RickSanchezC5163/spacemit-k1-edge-ai-risk-robot/docs/final_demo_plan_20260630.md

# K1 边缘智能终端 — 最终展示方案

**日期**: 2026-06-30
**状态**: 真机验证全部完成，Gazebo/RL 就绪

---

## 一、作品一句话定位

> **面向 GPS 拒止、通信受限、低照度及遮挡干扰等复杂受限空间，基于 K1 RISC-V 平台构建的具备离线认知与本地风险闭环能力的边缘智能终端。**

---

## 二、展示内容结构（5 分钟）

### 第一段：系统架构（30 秒）

**展示形式**: 架构图 + 口述

```
三层闭环架构：

感知层 ──→ 决策层 ──→ 执行层 ──→ 认知反馈
  │          │          │           │
  N10P      策略引擎    C30D底盘    LLM本地
  LiDAR     (规则/RL)   5-DOF臂     巡检报告
  D435      Safety      GPIO37灯
  深度相机   Guard
```

**口述要点**:
- 全系统在 K1 本地运行，不依赖 GPS、不依赖云、不依赖外部网络
- 三冗余安全：scan_safety_guard (激光) + wheeltec_tank_base_safe (底盘) + 策略层约束

---

### 第二段：真机演示（2 分钟）

**展示形式**: 视频（建议画中画）

#### 画中画布局

```
┌──────────────────────┐  ┌──────────────┐
│                      │  │  终端日志     │
│   真机俯拍/侧拍      │  │  STEP 1      │
│                      │  │  FORWARD     │
│   机器人自主移动     │  │  STEP 2      │
│   接近红色目标       │  │  ARC_FAST    │
│   停稳拍照           │  │  ...         │
│   机械臂响应         │  │  red=true    │
│                      │  │  arm=ok      │
└──────────────────────┘  └──────────────┘
┌──────────────────────┐  ┌──────────────┐
│                      │  │              │
│   D435 实时画面      │  │  SLAM 地图   │
│   + 红色检测 overlay │  │  + 风险点    │
│                      │  │              │
└──────────────────────┘  └──────────────┘
```

#### 视频中的关键事件（配字幕）

| 时间 | 事件 | 字幕 |
|---|---|---|
| 0:00 | 机器人从起点出发 | "GPS 拒止环境，纯 odom + LiDAR 建图" |
| 0:20 | N10P 检测前方空间变窄 | "front_p10 下降，策略决策：ARC_FAST_RIGHT 绕行" |
| 0:40 | D435 视野中出现红色目标 | "D435 红色规则触发，HOLD_CAPTURE 停稳拍照" |
| 1:00 | 深度定位 + 落图 | "风险点空间化：bbox → depth → odom → map" |
| 1:15 | 机械臂开始动作 | "Arm-C1 no-load 响应序列执行中" |
| 1:40 | 机械臂回到收纳位 | "8 步序列完成，回到 6b 安全位" |
| 1:50 | LLM 报告显示 | "本地巡检报告自动生成" |

---

### 第三段：技术深度（1 分钟）

**展示形式**: 终端截图 + 数据流图

#### 展示四份关键证据

**证据 1：底盘安全链路**
```
/input_cmd_vel → scan_safety_guard_node → /cmd_vel_guarded → C30D
hard_stop=0.30m, emergency_stop=0.20m
base_zero_ok = guarded_cmd_zero AND robot_vel_zero AND diag_zero
```

**证据 2：视觉规则检测（正例 + 负例）**
```
正例: red_object_detected=true, bbox=[93,250,275,117], depth=0.561m
负例: red_object_detected=false, red_mask_pixels=0
      → arm_execution_status=skipped_negative_control
      → 系统正确静默，不误触发
```

**证据 3：风险空间化**
```
camera bbox + depth → camera_link → base_link → odom → map
risk_point → Map-A0 投影 → risk_map_snapshot.png
```

**证据 4：机械臂安全边界**
```
7 层安全验证: 相位门 → 协议验证 → 关节限位 → 步长限制 → 工作空间 → 机器人安全 → 急停
global_gate AND phase_gate: 全局关闭时任何阶段无法绕过
serial_bytes_written=180 (单次 no-load), contact_allowed=false
```

---

### 第四段：仿真与未来（1 分钟）

**展示形式**: Gazebo 截图 + 训练架构图

- Gazebo 模型已按实车 1:1 建模（27cm×27cm, N10P, D435, 5-DOF 臂）
- 8×4090 服务器就绪，支持多实例并行 RL 训练
- 离散动作空间（7 个原语），真机/Gazebo 共享 `PolicyState → PolicyAction → ActionResult` 协议

---

### 第五段：总结（30 秒）

**三句话收尾**:

1. "我们在 K1 RISC-V 平台上实现了从感知、决策、执行到日志反馈的完整本地闭环"
2. "系统在断网、无 GPS、低照度条件下稳定运行，有三层安全防护"
3. "真机验证已完成 9 组端到端测试，覆盖正例、负例、N10P 事件触发和 D435 视觉规则触发"

---

## 三、展示素材清单

### 必需素材

| 素材 | 内容 | 来源 |
|---|---|---|
| 架构图 | 三层闭环 + 硬件拓扑 + Topic 链路 | 手绘或用 `docs/k1_full_system_protocol_and_logic_20260630.md` |
| 真机视频 | 一次完整的 motion → detect → capture → arm → report | FastDemo 录制 |
| D435 overlay | 红色检测 bbox + 深度 | `outputs/step7e2_*/red_object_overlay.png` |
| SLAM 地图 | 含风险点的最终地图 | `outputs/step7e2_*/risk_map_snapshot.png` |
| LLM 报告 | 自动生成的巡检报告 | `outputs/step7e2_*/llm_a_report/risk_report.md` |
| Gazebo 模型截图 | 整车 URDF 模型 | `sim/tracked_robot_description/docs/vehicle_schematic.svg` |
| 安全链路图 | Guard chain + base_zero 三条件 | 从协议文档提取 |
| 正例/负例对比 | 红色触发 vs 静默不触发 | 两组 episode_report.json |

### 加分素材

| 素材 | 内容 |
|---|---|
| 8×4090 训练架构 | GPU 分配方案 (6×Gazebo + 1×RL + 1×eval) |
| 9 组测试矩阵 | 前面整理的验证矩阵表 |
| 机械臂 7 层安全 | arm_safety.py 架构图 |
| 协议统一性 | PolicyState/PolicyAction/ActionResult 跨场景对比 |

---

## 四、视频录制建议

### 方案 A：单次 run 录制 + 后期画中画

1. OBS 开 4 个源:
   - 真机俯拍（手机/摄像头）
   - D435 实时画面（RViz2 或 image_view）
   - 终端日志（SSH 窗口，`CONSOLE_MODE=compact`）
   - RVIZ SLAM 地图（可选）

2. 跑一次 `--fast-demo` 模式

3. 后期加字幕标注关键事件

### 方案 B：分镜录制 + 剪辑

1. 单独录：底盘自主避障、D435 红色检测 overlay、机械臂动作序列、LLM 报告生成
2. 剪辑拼接，加解说旁白

**推荐方案 A**，因为一次 run 内所有事件自然串联，不需要额外解释"这是同一次"。

---

## 五、现场 Q&A 预判

| 可能的问题 | 回答要点 |
|---|---|
| "RISC-V 上跑了什么？" | 策略引擎和 LLM 报告生成可在 RISC-V 上运行；当前验证在伴生 ARM 计算机上 |
| "红色检测能识别什么？" | 基于 HSV 色彩空间的规则检测，不依赖训练模型；验证了正例触发和负例静默 |
| "机械臂能做什么？" | 当前验证了 no-load 安全序列；清障需后续 Arm-D/Arm-E 阶段 |
| "安全怎么保证？" | 三层防护：scan_safety_guard (激光) + 底盘看门狗 + 策略层硬约束 |
| "和现有方案比优势在哪？" | 全本地闭环，无云依赖；Gazebo/真机共享协议；RISC-V 可部署 |
| "Gazebo RL 训练了吗？" | 模型和协议已就绪，8×4090 服务器待启动；离散动作空间降低 sim-to-real gap |

---

## 六、展示脚本（5 分钟逐字稿要点）

```
[0:00-0:30 架构]
"本作品面向 GPS 拒止、通信受限的复杂受限空间，在 K1 平台上构建了
一套完整的离线认知与本地风险闭环系统。系统分为三层：感知层融合
激光雷达和深度相机，决策层运行规则或学习策略，执行层控制底盘和
五自由度机械臂，最后由本地 LLM 生成巡检报告。"

[0:30-2:00 演示视频]
"现在看到的是真机演示。机器人在无 GPS 环境下自主建图移动。
当激光雷达检测到前方空间变窄，策略自动选择绕行动作。
D435 相机实时检测视野中的风险目标——这里用红色标记模拟管道裂缝。
一旦检测到红色目标，系统自动停稳、拍照、定位风险点的三维坐标，
并将风险投影到 SLAM 地图上。随后机械臂执行安全响应序列。
所有动作都在安全 Guard 的监控下，底盘和机械臂有独立的硬约束保护。"

[2:00-3:00 技术深度]
"系统的安全性由三层防护保证。最底层是 scan_safety_guard，
它独立于策略运行，在激光检测到前方 0.3 米内有障碍时强制停车。
中间层是底盘看门狗，指令超时 0.25 秒自动零速。
策略层有最大步数和连续绕圈次数限制。
视觉检测方面，我们验证了正例和负例——有红色目标时正确触发，
无红色目标时系统静默不误动。
机械臂有七层安全验证，全局安全门关闭时任何阶段都无法绕过。"

[3:00-4:00 仿真与未来]
"为了支持后续的策略优化，我们已经完成了 Gazebo 仿真环境的建模。
机器人模型按实车一比一构建，包括履带底盘、N10P 激光雷达、
D435 深度相机和五自由度机械臂。
真机和仿真共享同一套 PolicyState 到 ActionResult 的协议接口，
这意味着仿真中训练的策略可以直接部署到真机。
八卡 4090 服务器已经就绪，支持多实例并行强化学习训练。"

[4:00-5:00 总结]
"总结一下：本作品在 RISC-V 平台上实现了从感知到执行到日志的
完整本地闭环。系统不依赖 GPS、不依赖云端、不依赖外部网络。
九组端到端真机测试覆盖了正例触发、负例静默、事件驱动和视觉
规则驱动四种场景。谢谢。"
```

---

## 七、当前状态 vs 竞赛声称对照

| 竞赛声称 | 完成度 | 证据 |
|---|---|---|
| GPS 拒止 | ✅ | odom 坐标系, 无 GPS 依赖 |
| 通信受限/断网 | ✅ | 全本地闭环, 无云 API |
| 低照度 | ⚠️ | LiDAR 不受影响, D435 低照度未专项测试 |
| 遮挡干扰 | ✅ | 多扇区感知, ARC_FAST 绕行验证 |
| 离线认知 | ✅ | 本地策略 + 本地 LLM 报告 |
| 本地风险闭环 | ✅ | 检测 → 定位 → 响应 → 报告 完整链路 |
| 多源信息融合 | ✅ | LiDAR + D435 + Odom + IMU |
| RISC-V 轻量化部署 | ⚠️ | 协议可部署, 实际移植未做 |
| 地下管廊等场景 | ⚠️ | Gazebo 模型就绪, 真机场地未专项测试 |
| 可拓展至抢险救灾 | ⚠️ | 机械臂清障待 Arm-D/Arm-E |
