RickSanchezC5163/spacemit-k1-edge-ai-risk-robot/demo/README.md

# Demo

此目录用于放置压缩后的演示视频样例和最终演示视频。

当前正式演示视频：

- `基于K1MusePiPro的复杂受限空间离线认知边缘智能终端.mp4`

补充调试与录屏材料：

- `demo_clip_20260708_220330.mp4`：开源提交用压缩演示片段。
- `recordings/录屏 2026年07月11日 00时59分50秒.webm`：Ubuntu 仿真建图调试录屏。
- `recordings/录屏 2026年07月11日 01时19分55秒.webm`：Gazebo/RViz 对齐和建图录屏。
- `recordings/录屏 2026年07月11日 01时42分10秒.webm`：较完整的 SLAM-Frontier/RRT/Nav2 自主探图录屏。

如果后续提交平台要求外链，可同步上传至 GitHub Release、网盘或比赛指定平台，并在 `SUBMISSION.md` 中补充链接。
