RickSanchezC5163/spacemit-k1-edge-ai-risk-robot/docs/汇报.md

# 组会汇报稿

这段时间我主要完成了小车从硬件驱动到边缘 AI 演示链路的基础打通，现在项目已经从“单个模块调通”推进到“整车稳定运行和演示链路打磨”阶段，准备在接下来几天补齐资料，上交素材。

作品主要是基于N10P雷达、D435深度相机的对于外部环境的感知,通过N10P雷达进行稳定的二维建图,结合YOLO模型识别地图上的风险点,并结合深度相机的雷达数据,准确地标定出地图上某个位置存在的风险。同时如果有堵塞的识别,最后通过机械臂进行排障的一个对于受限环境内的整个风险的排查系统。
整车的自主操作实现基于gazebo仿真和ROS2 Humble的Nav2导航栈,通过RRT算法进行自主建图和路径规划,结合雷达和深度相机的感知数据,实现对于受限环境内的自主探索和风险排查。

其中，雷达30Hz，车底盘20Hz，D435 30Hz。YoloV8n 10Hz，Qwen-0.5b模型每秒20 tokens。
YoloV8n Qwen-0.5b模型都是本地部署的，完全不依赖云端推理。基于官方提供的Ep核加速，相比于全cpu有明显的性能提升。

结合题目要求,需要本地部署大模型,此处考虑到了对于风险识别的汇总应用。大模型主要是通过对于本地资料,比如说图片、文字,我们的风险汇报的汇总,结合具体的地图环境，最后呈现给用户一个稳定的受限区域内地图样貌，地图上的各个风险判定,以及我们车自主完成的一些风险排查动作的汇报。

### 现在进度： 
1. yolov8n的本地部署
2. RRT的自主建图
3. 机械臂的排障动作
4. 低照度补光灯的控制
5. 本地大模型的部署和运行都已经完成

### 现在尚待补充的内容主要是：
1. 进一步提高整车长时间运行稳定性
2. 整理演示视频、运行日志和关键指标数据
3. 完善 PPT 里的技术路线和评奖材料
4. 后续准备补充RRT辅助RL训练的自主探索和排障动作,实现对于风险事件的解释和处置建议生成

## 1. 底层硬件联调

目前 K1 Muse Pi Pro 已经重新刷入 Bianbu LXQT v2.3.3 比赛固件，并完成了 ROS2 Humble 环境适配。

底盘使用 C30D Tank 固件，N10P 雷达、D435 深度相机、PWM 补光灯、总线舵机和本地 LLM 服务都已经完成基础接入测试。

其中底盘一开始存在停车拖尾和 odom 严重不准的问题。后面通过修改 STM32 固件里的编码器参数，把 Tank 车型从错误的 500 线光电编码器参数改成 GMR 编码器参数，odom 和实际运动的一致性明显改善。

## 2. 安全底盘和建图链路

目前已经跑通：

```text
N10P /scan
+ C30D /odom
+ odom -> base_footprint TF
+ slam_toolbox /map
```

同时加了一层安全控制，不让 Nav2 或手动速度直接裸连底盘。

当前结构是：

```text
/input_cmd_vel 或 Nav2 /cmd_vel_raw
-> scan_safety_guard_node
-> /cmd_vel_guarded
-> Python Tank base
-> C30D
```

这样可以做低速人工建图、小目标 Nav2 测试，并且前方有障碍时可以触发安全停车。

目前还没有宣称完整自动探索，只是完成了“人工/受控低速建图 + 安全停车”的 MVP。

## 3. 视觉和风险闭环

### 3.1 硬件和模型部署

- D435 相机：完成 RGB 和深度采集测试
- YOLO 风险检测模型：已部署本地推理

### 3.2 完整处理链路

```text
D435 图像
  ↓
YOLO 本地推理
  ↓
风险事件生成
  ↓
event_logger 记录
  ↓
地图上生成风险点
  ↓
输出报告和可视化结果
```

### 3.3 核心价值

端侧视觉识别，不依赖云端推理，充分体现 RISC-V 端侧 AI 能力。

## 4. 本地 LLM 和认知层

现在本地 LLM 已经部署完成，后续重点不是再证明“能不能跑”，而是稳定运行和接入完整任务链路。

LLM 主要负责：

```text
风险事件解释
处置建议生成
任务过程摘要
演示问答和报告生成
```

这样系统可以形成：

```text
传感器感知
-> 本地模型识别
-> 风险分级
-> 本地 LLM 解释和总结
-> 执行反馈
```

这部分是项目里“RISC-V 端侧 AI”的重要体现。

## 5. 低照度补光闭环

目前已经完成 PWM 灯控测试，可以通过软件控制补光灯亮灭和亮度调节。

现在也做了自适应补光逻辑：

```text
D435 检测低照度
-> 系统自动调整补光亮度
-> 再次观察画面亮度是否恢复
-> 记录风险事件和处理结果
```

这个可以作为一个比较清晰的比赛演示场景：

```text
低光环境下，机器人自动补光并重新评估风险。
```

## 6. 机械臂和排障接口

总线舵机已经完成串口控制测试，多个舵机编号和基础动作都已经验证。

目前机械臂部分还没有做真实负载排障，当前定位是“人工确认后的空载固定动作响应”，避免现阶段误动作损坏结构。

## 7. 当前完整演示链路

目前项目已经形成了一条比较完整的初赛演示链：

```text
低速建图
-> 发现低照度或障碍风险
-> D435/YOLO 本地识别
-> 风险分级和日志记录
-> 自动补光或停车
-> 本地 LLM 输出风险解释和处置建议
-> 地图/报告中输出风险点
-> 人工确认后机械臂执行固定响应动作
```

## 8. 下一步计划

接下来我准备优先做三件事：

1. 继续提高整车长时间运行稳定性。
2. 整理演示视频、运行日志和关键指标数据。
3. 完善 PPT 里的技术路线和评奖材料。

整体重点会放在：

```text
RISC-V 端侧 AI
多源感知
本地 LLM 认知解释
安全运动闭环
离线运行能力
```
