RickSanchezC5163/spacemit-k1-edge-ai-risk-robot/evidence/p4_guarded_auto_mapping_20260629/maps/spatial_s_p4r_20260629_001054_01_forward_0p15_marked_zoom.png

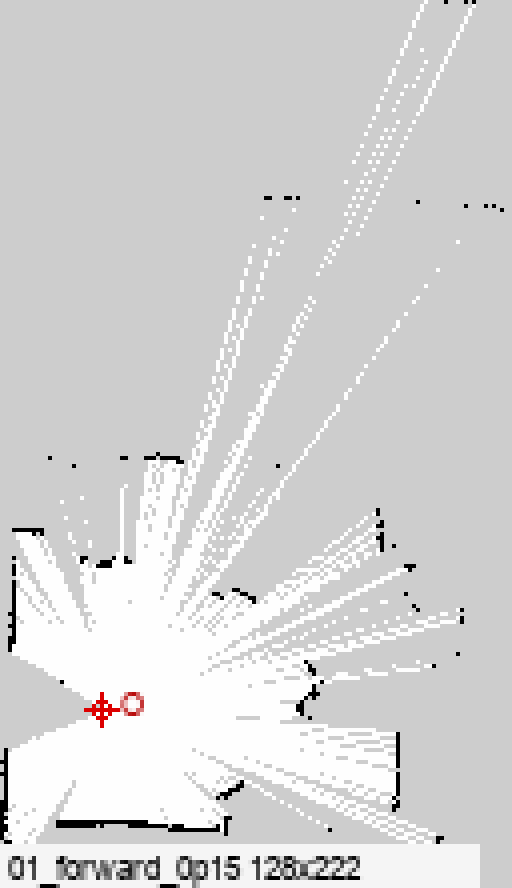
evidence/p4_guarded_auto_mapping_20260629/maps/spatial_s_p4r_20260629_001054_01_forward_0p15_marked_zoom.png
