RickSanchezC5163/spacemit-k1-edge-ai-risk-robot/maps/prelim_remote_mapping/map_20260703_095806_preview.png

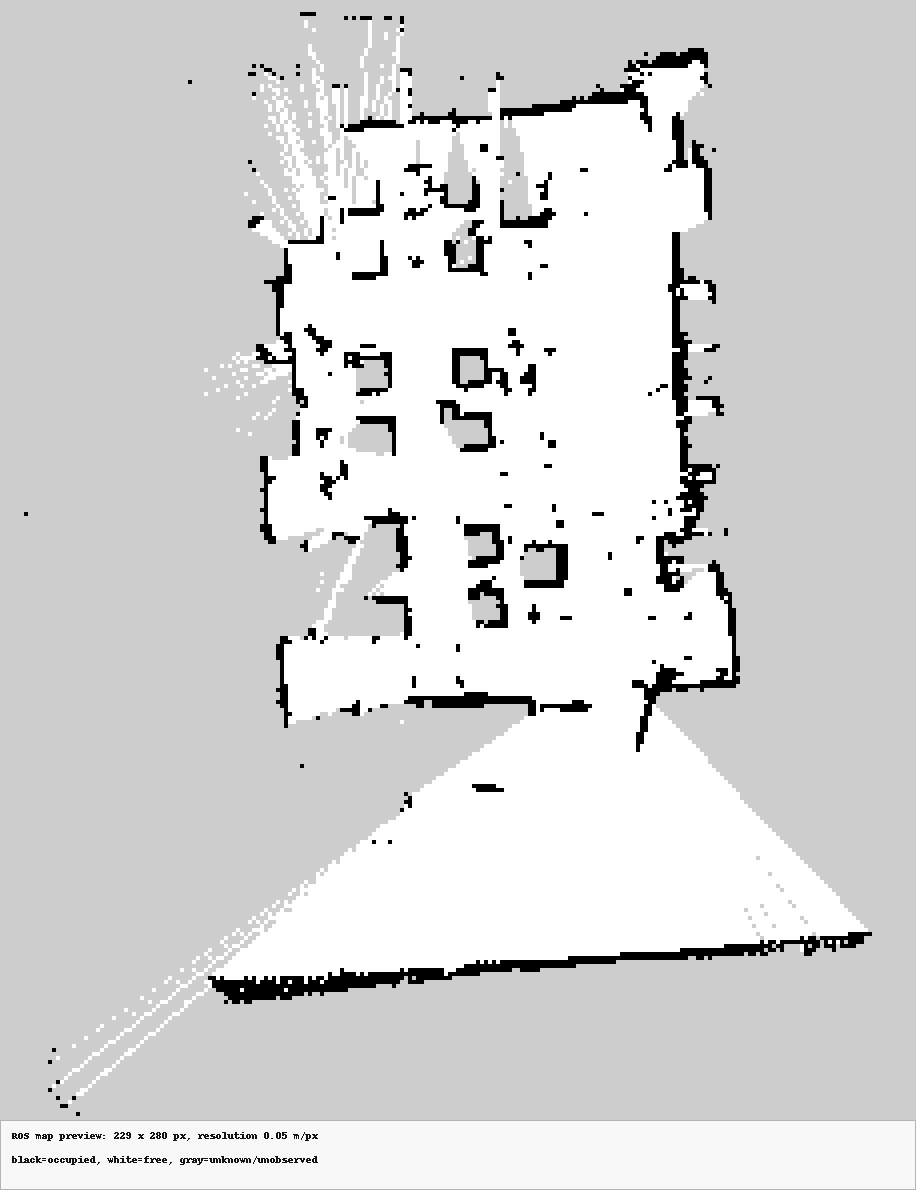
maps/prelim_remote_mapping/map_20260703_095806_preview.png
