RickSanchezC5163/spacemit-k1-edge-ai-risk-robot/maps/prelim_remote_mapping/map_only_20260706_191353_preview.png

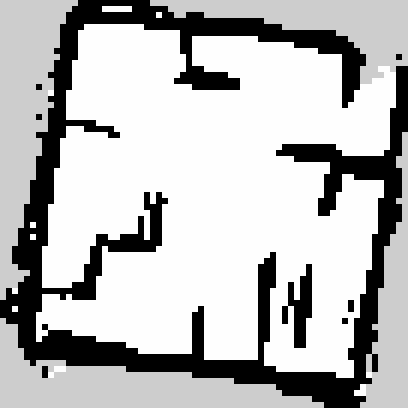
maps/prelim_remote_mapping/map_only_20260706_191353_preview.png
