RickSanchezC5163/spacemit-k1-edge-ai-risk-robot/maps/prelim_remote_mapping/map_rerun_20260706_192358_preview.png

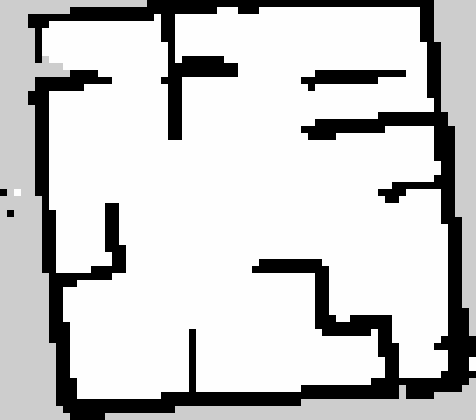
maps/prelim_remote_mapping/map_rerun_20260706_192358_preview.png
