RickSanchezC5163/spacemit-k1-edge-ai-risk-robot/maps_preview/current_map_preview_20260627.png

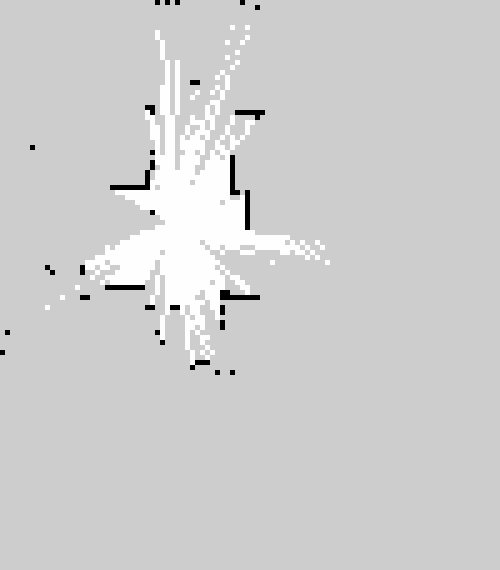
maps_preview/current_map_preview_20260627.png
