RickSanchezC5163/spacemit-k1-edge-ai-risk-robot/maps_preview/mapping_fixed_odom_20260628_085623.png

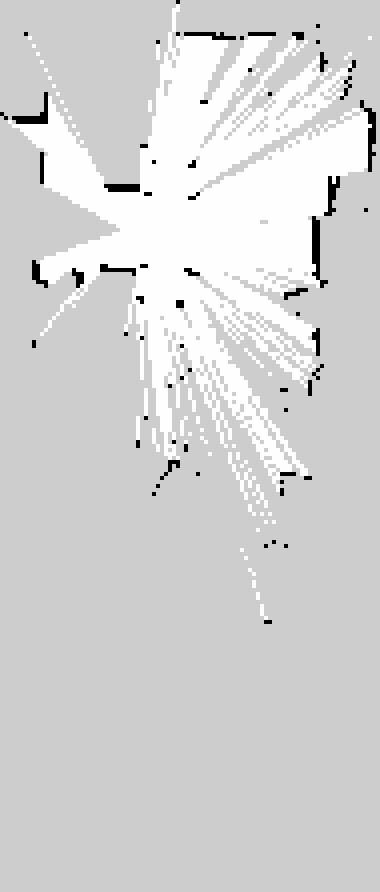
maps_preview/mapping_fixed_odom_20260628_085623.png
