RickSanchezC5163/spacemit-k1-edge-ai-risk-robot/maps_preview/mapping_motion_20260628_031830.png

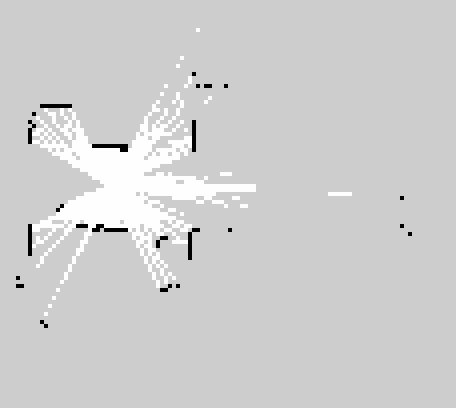
maps_preview/mapping_motion_20260628_031830.png
