RickSanchezC5163/spacemit-k1-edge-ai-risk-robot/maps_preview/mapping_scaled_forward_20260628_032434.png

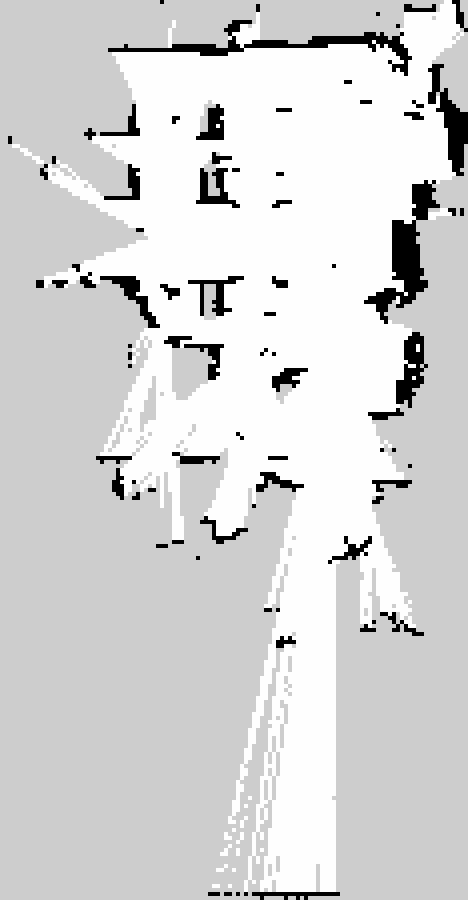
maps_preview/mapping_scaled_forward_20260628_032434.png
