RickSanchezC5163/spacemit-k1-edge-ai-risk-robot/maps_preview/nav2_guarded_goal_map_20260627.png

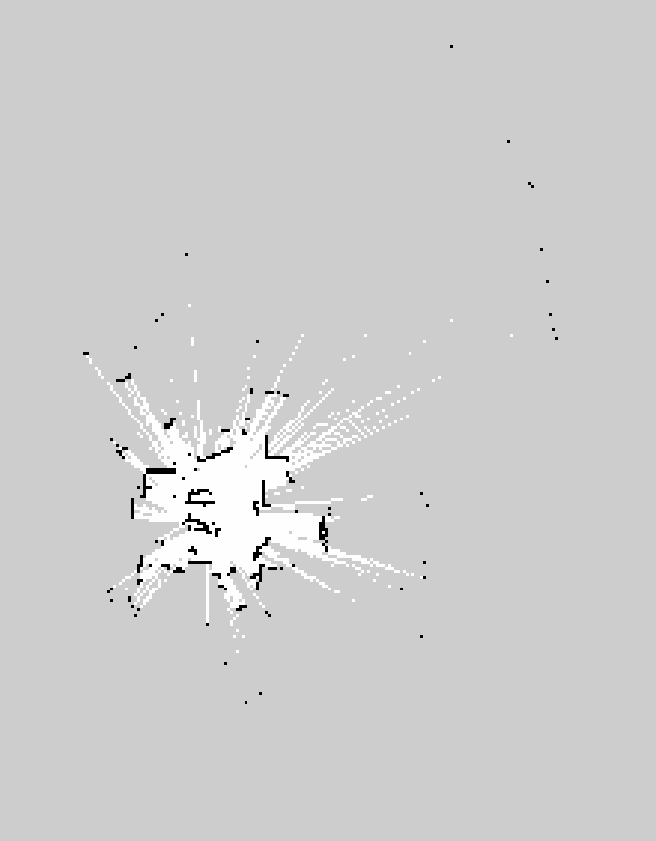
maps_preview/nav2_guarded_goal_map_20260627.png
