RickSanchezC5163/spacemit-k1-edge-ai-risk-robot/sim/tracked_robot_description/docs/vehicle_reference.png

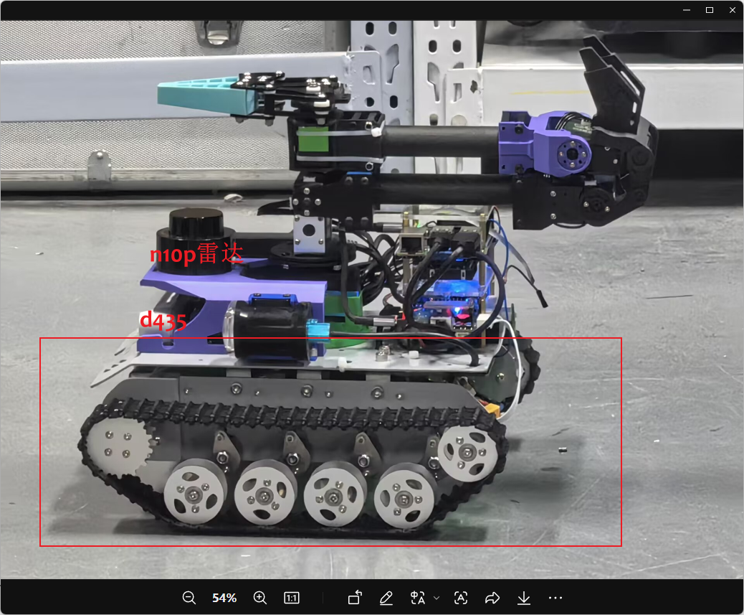
sim/tracked_robot_description/docs/vehicle_reference.png
