RickSanchezC5163/spacemit-k1-edge-ai-risk-robot/assets/sw2urdf_raw/mechanical_arm_1/meshes/Link4.STL

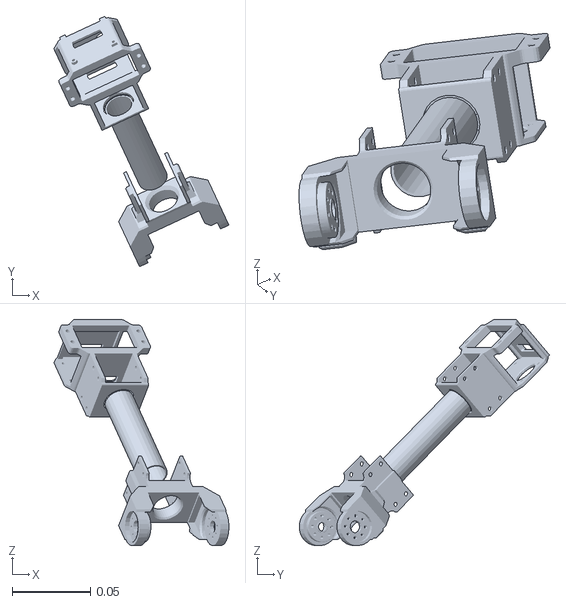
[picture p47: CAD file, 2026-07-11]
assets/sw2urdf_raw/mechanical_arm_1/meshes/Link4.STL
0.112 x 0.16 x 0.144
