RickSanchezC5163/spacemit-k1-edge-ai-risk-robot/sim/mechanical_arm_1_description/meshes/Link1.STL

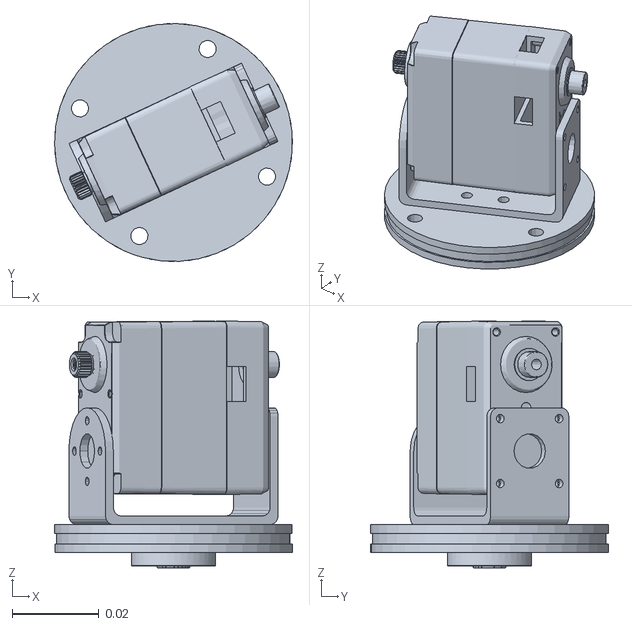
[picture p48: CAD file, 2026-07-11]
sim/mechanical_arm_1_description/meshes/Link1.STL
0.055 x 0.055 x 0.057
