RickSanchezC5163/spacemit-k1-edge-ai-risk-robot/assets/sw2urdf_raw/mechanical_arm_1/meshes/Link3.STL

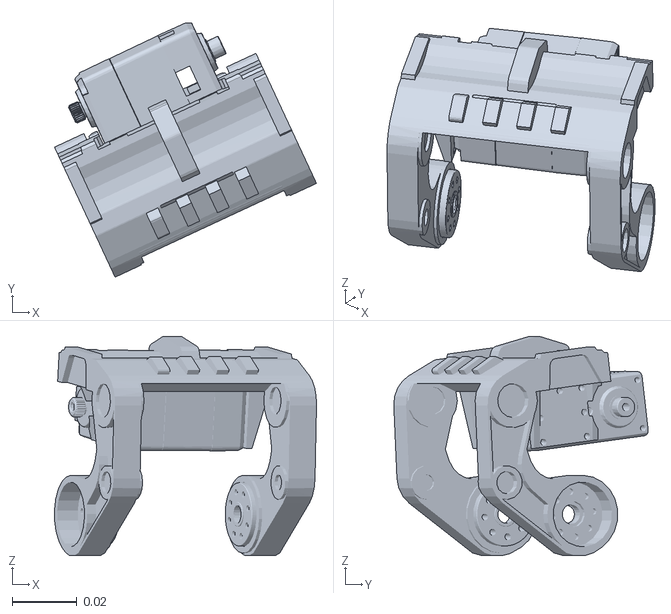
[picture p49: CAD file, 2026-07-11]
assets/sw2urdf_raw/mechanical_arm_1/meshes/Link3.STL
0.0808 x 0.0784 x 0.0676
