RickSanchezC5163/spacemit-k1-edge-ai-risk-robot/sim/mechanical_arm_1_description/meshes/Link2.STL

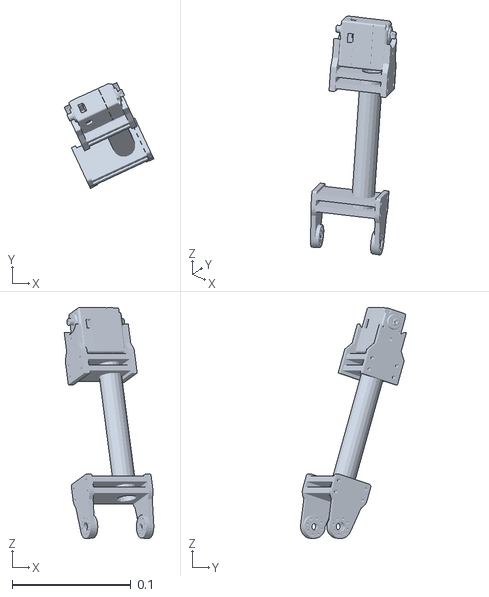
[picture p50: CAD file, 2026-07-11]
sim/mechanical_arm_1_description/meshes/Link2.STL
0.0757 x 0.0894 x 0.195
