RickSanchezC5163/spacemit-k1-edge-ai-risk-robot/assets/sw2urdf_raw/mechanical_arm_1/meshes/base_link.STL

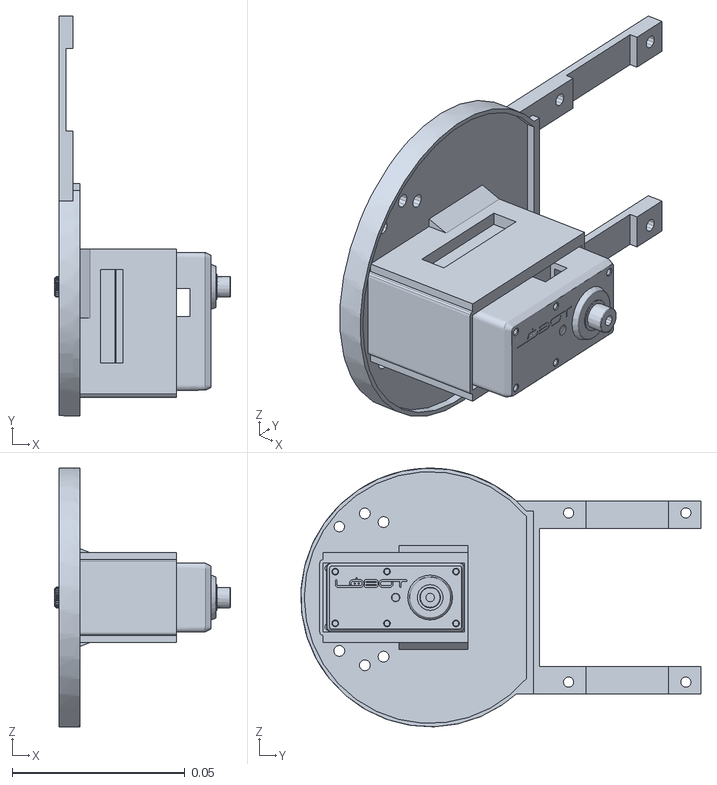
[picture p51: CAD file, 2026-07-11]
assets/sw2urdf_raw/mechanical_arm_1/meshes/base_link.STL
0.0511 x 0.116 x 0.0749
