RickSanchezC5163/spacemit-k1-edge-ai-risk-robot/docs/step7c1_arm_c1h_freeze_20260630.md

# Step7-C1 / Arm-C1-H Freeze

Date: 2026-06-30

Status: frozen after one supervised hardware no-load run.

## Evidence Directory

```text
outputs/step7c_guarded_d435_mockrisk_arm_noload_v1/hw_001/
```

Core evidence files:

- `episode_report.json`
- `step7c_report.md`
- `errors.json`
- `base_zero_live/base_zero_evidence.json`
- `d435_hold_capture/episode_report.json`
- `mock_risk/mock_risk_summary.json`
- `map_projection/risk_map_points.json`
- `arm_candidate/episode_report.json`
- `arm_execution/episode_report.json`
- `arm_execution/physical_actuation_confirmation.json`
- `llm_a_report/risk_report.md`
- `llm_a_report/risk_report.json`
- `llm_a_report/claim_boundary.md`

## Frozen Result

- `status=succeeded`
- `arm_mode=hardware_once`
- `base_zero_ok_before_capture=true`
- `base_zero_ok_before_arm=true`
- `d435_live_capture_executed=true`
- `risk_point_generated=true`
- `mock_risk_triggered=true`
- `risk_map_points=1`
- `projected=1`
- `arm_candidate_selected=true`
- `selected_sequence=arm_b3_8_step_safety_adjusted_no_load_sample`
- `arm_execution_status=succeeded`
- `hardware_executed=true`
- `serial_port_opened=true`
- `serial_bytes_written=180`
- `published_cmd_vel=false`
- `contact_allowed=false`
- `obstacle_removed=false`
- `final_pose_observed=6b`
- `physical_actuation_observed=true`
- `returned_to_6b_observed=true`
- `physical_issue_observed=false`
- `errors.json=[]`
- LLM-A deterministic report status: `PASS`

Schema validation returned `ok=true`; the only warning is the expected
`succeeded_dry_run` status for the Arm-C0 candidate step.

## Operator Observation

The operator confirmed:

```text
No abnormal issue observed; final pose returned to 6b.
```

## Claim Boundary

Allowed claim:

```text
Step7-C1 / Arm-C1-H completed one supervised map-gated no-load integrated
validation. After fresh live base-zero evidence passed, the system performed
one live D435 capture, generated one deterministic mock risk point, projected
one approximate risk-map point, selected one validated no-load arm candidate,
executed the Arm-B3 8-step no-load sequence once, published no cmd_vel, made no
contact, removed no obstacle, and returned to 6b.
```

Disallowed claims:

- no real visual detection accuracy claim
- no grasping claim
- no contact claim
- no payload or load-handling claim
- no obstacle-removal claim
- no autonomous navigation claim
- no path-planning success claim
- no SLAM or high-precision mapping claim
- no LLM control claim
- no claim that this evidence authorizes repeated hardware runs

## Freeze Decision

Do not rerun Step7-C1 automatically. Further hardware tests require a new test
name, fresh base-zero evidence, explicit hardware confirmation flags, and a new
safety boundary.
