RickSanchezC5163/spacemit-k1-edge-ai-risk-robot/maps/prelim_remote_mapping/map_risk_live_20260703_103217_preview.png

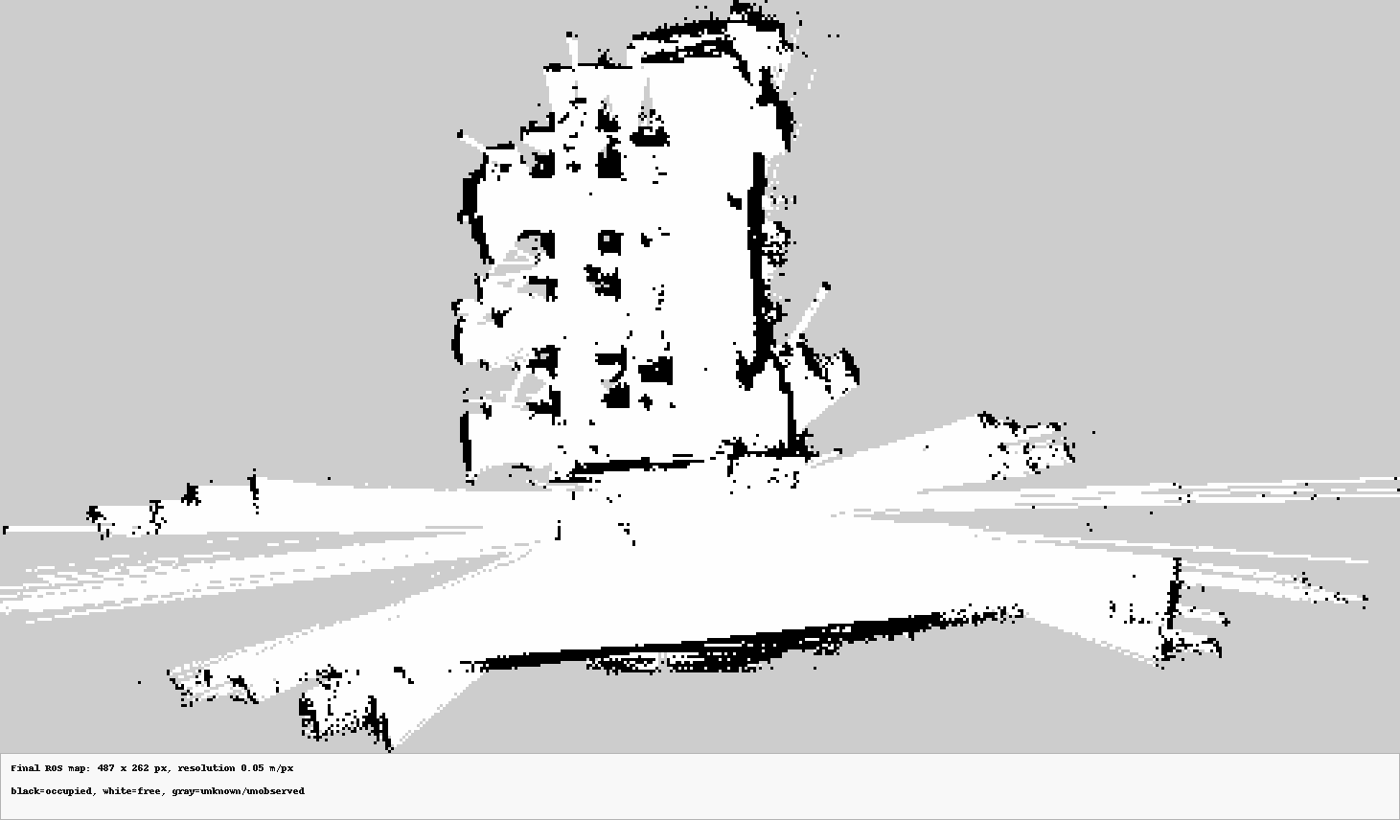
maps/prelim_remote_mapping/map_risk_live_20260703_103217_preview.png
