RickSanchezC5163/spacemit-k1-edge-ai-risk-robot/ros2_ws/src/turn_on_wheeltec_robot/src/wheeltec_robot.cpp

#include "turn_on_wheeltec_robot/wheeltec_robot.h"
#include "turn_on_wheeltec_robot/Quaternion_Solution.h"
#include "wheeltec_robot_msg/msg/data.hpp" 

//sensor_msgs::msg::Imu Mpu6050;//Instantiate an IMU object //实例化IMU对象 

using std::placeholders::_1;
using namespace std;
rclcpp::Node::SharedPtr node_handle = nullptr;

//自动回充使用相关变量
bool check_AutoCharge_data = false;
bool charge_set_state = false;
double last_A,last_B,last_C,last_grap;

//超声波相关标志位
bool distance_flag=false;

//底盘安全等级设置位
bool SecurityPLY = 0;

//超声波传感器数据
float distanceA=5.1f;
float distanceB=5.1f;
float distanceC=5.1f;
float distanceD=5.1f;
float distanceE=5.1f;
float distanceF=5.1f;
float distanceG=5.1f;
float distanceH=5.1f;

//BCC校验函数
uint8_t Calculate_BCC(const uint8_t* checkdata,uint16_t datalen)
{
	char bccval = 0;
	for(uint16_t i=0;i<datalen;i++)
	{
		bccval ^= checkdata[i];
	}
	return bccval;
}

static double clamp_double(double value, double low, double high)
{
  return std::max(low, std::min(value, high));
}

static bool velocity_nonzero(double linear_x, double linear_y, double angular_z, double threshold)
{
  return fabs(linear_x) > threshold || fabs(linear_y) > threshold || fabs(angular_z) > threshold;
}

/**************************************
Date: January 28, 2021
Function: The main function, ROS initialization, creates the Robot_control object through the Turn_on_robot class and automatically calls the constructor initialization
功能: 主函数，ROS初始化，通过turn_on_robot类创建Robot_control对象并自动调用构造函数初始化
***************************************/
int main(int argc, char** argv)
{
  rclcpp::init(argc, argv); //ROS initializes and sets the node name //ROS初始化 并设置节点名称 
  turn_on_robot Robot_Control;//Instantiate an object //实例化一个对象
  Robot_Control.Control();//Loop through data collection and publish the topic //循环执行数据采集和发布话题等操作
  return 0;  
} 

/**************************************
Date: January 28, 2021
Function: Data conversion function
功能: 数据转换函数
***************************************/
short turn_on_robot::IMU_Trans(uint8_t Data_High,uint8_t Data_Low)
{
  short transition_16;
  transition_16 = 0;
  transition_16 |=  Data_High<<8;   
  transition_16 |=  Data_Low;
  return transition_16;     
}
float turn_on_robot::Odom_Trans(uint8_t Data_High,uint8_t Data_Low)
{
  float data_return;
  short transition_16;
  transition_16 = 0;
  transition_16 |=  Data_High<<8;  //Get the high 8 bits of data   //获取数据的高8位
  transition_16 |=  Data_Low;      //Get the lowest 8 bits of data //获取数据的低8位
  data_return   =  (transition_16 / 1000)+(transition_16 % 1000)*0.001; // The speed unit is changed from mm/s to m/s //速度单位从mm/s转换为m/s
  return data_return;
}

//设置灯带颜色
void turn_on_robot::Set_LightRgb_Callback(const std_msgs::msg::UInt8MultiArray::SharedPtr msg)
{
    // 检查数据长度是否为 4
    if (msg->data.size() != 4) {
      RCLCPP_ERROR(this->get_logger(), "Data length error. It must be 4. Got %zu elements.", msg->data.size());
      return;
    }

  // 解析数据：索引 0 为 bool (0 或 1)，索引 1-3 为 uint8
  uint8_t en_flag = (msg->data[0] == 1);
  uint8_t r = msg->data[1];
  uint8_t g = msg->data[2];
  uint8_t b = msg->data[3];
// RCLCPP_INFO(this->get_logger(), "light: R=%d, G=%d, B=%d, en_flag=%s",
//                 static_cast<int>(r), static_cast<int>(g), static_cast<int>(b),
//                 en_flag ? "true" : "false");

  Send_Data.tx[0]=FRAME_HEADER;
  Send_Data.tx[1] = 04; //04代表本帧的功能为设置灯带
  Send_Data.tx[2] = en_flag;//设置使能位
  Send_Data.tx[3] = r;
  Send_Data.tx[4] = g;
  Send_Data.tx[5] = b;
  Send_Data.tx[6] = 0;Send_Data.tx[7] = 0;Send_Data.tx[8] = 0;
  Send_Data.tx[9]=Check_Sum(9,SEND_DATA_CHECK); //For the BCC check bits, see the Check_Sum function //BCC校验位，规则参见Check_Sum函数
  Send_Data.tx[10]=FRAME_TAIL; //frame tail 0x7D //帧尾0X7D
  try
  {
    Stm32_Serial.write(Send_Data.tx,sizeof (Send_Data.tx)); //Sends data to the downloader via serial port //通过串口向下位机发送数据 
  }
  catch (serial::IOException& e)   
  {
    RCLCPP_ERROR(this->get_logger(),("Unable to send data through serial port")); //If sending data fails, an error message is printed //如果发送数据失败，打印错误信息
  }
}


//避障实现函数
geometry_msgs::msg::Twist turn_on_robot::avoid_obstacle(const geometry_msgs::msg::Twist& twist)
{
  geometry_msgs::msg::Twist avoid_twist = twist; // 复制输入的 twist 数据

  float base_vz = PI/4.0f;

	//避障标志位-前
	uint8_t avoid_front = 0;
	
	//避障标志位-后
	uint8_t avoid_back = 0;

  if( ranger_avoid_flag == 1 )
  {
    //s300 mini 车型
    if( car_mode.find("s300") != std::string::npos && car_mode.find("mini") != std::string::npos )
    {
      if( distanceA < 0.4f || distanceB < 0.4f || distanceC < 0.4f || 
        distanceD < 0.4f || distanceE < 0.4f )
      {
        avoid_front=1;
        if( avoid_twist.linear.x > 0 )
        {
          if( distanceA+distanceB > distanceD+distanceE)
          {
            //左转
            avoid_twist.angular.z = (avoid_twist.linear.x/0.5f)*base_vz;
          }
          else
          {
            //右转
            avoid_twist.angular.z = -(avoid_twist.linear.x/0.5f)*base_vz;
          }
          avoid_twist.linear.x = 0;
        }
      }
    }

    //s300
    else if ( car_mode.find("s300") != std::string::npos)
    {
      if( distanceA < 0.4f || distanceB < 0.4f || distanceC < 0.4f || 
        distanceD < 0.4f || distanceE < 0.4f || distanceF < 0.4f )
      {
        avoid_front=1;

        if( avoid_twist.linear.x > 0 )
        {
          if( distanceA+distanceB+distanceD > distanceD+distanceE+distanceF)
          {
            //左转
            avoid_twist.angular.z = (avoid_twist.linear.x/0.5f)*base_vz;
          }
          else
          {
            //右转
            avoid_twist.angular.z = -(avoid_twist.linear.x/0.5f)*base_vz;
          }
          avoid_twist.linear.x = 0;
        }
      }
    }

    //s200 / s260
    else if ( car_mode.find("s200") != std::string::npos || car_mode.find("s260") != std::string::npos )
    {
      if( distanceA < 0.4f || distanceB < 0.4f || distanceC < 0.4f || distanceD < 0.4f )
      {
        avoid_front=1;
        if( avoid_twist.linear.x > 0 && avoid_front==1 )
        {
          if( distanceA+distanceB > distanceC+distanceD )
          {
            //右转
            avoid_twist.angular.z = -(avoid_twist.linear.x/0.5f)*base_vz;
          }
          else
          {
            //左转
            avoid_twist.angular.z = (avoid_twist.linear.x/0.5f)*base_vz;
          }
          avoid_twist.linear.x=0;
        }
      }

      if( distanceE < 0.4f || distanceF < 0.4f)
      {
        avoid_back=1;
        if( avoid_twist.linear.x < 0 && avoid_back==1 && charge_set_state==0 )
        {
          avoid_twist.linear.x = 0;//后避障仅禁止后退,且自动回充不开启时才使能
        }
      }
    }

    //割草机
    else if( car_mode.find("v650") != std::string::npos )
    {

    }

    //未指定的车型
    else
    {
      avoid_front=0;
      avoid_back=1;
    }
  }

  return avoid_twist;
}

/**************************************
Date: January 28, 2021
Function: The speed topic subscription Callback function, according to the subscribed instructions through the serial port command control of the lower computer
功能: 速度话题订阅回调函数Callback，根据订阅的指令通过串口发指令控制下位机
***************************************/
void turn_on_robot::Cmd_Vel_Callback(const geometry_msgs::msg::Twist::SharedPtr ori_twist_aux)
{
  geometry_msgs::msg::Twist avoid_twist_cached = avoid_obstacle(*ori_twist_aux);
  current_linear_x = clamp_double(avoid_twist_cached.linear.x, -max_linear_x, max_linear_x);
  current_linear_y = clamp_double(avoid_twist_cached.linear.y, -max_linear_y, max_linear_y);
  current_angular_z = clamp_double(avoid_twist_cached.angular.z, -max_angular_z, max_angular_z);
  last_cmd_time = this->get_clock()->now();
  has_received_cmd = true;
}


void turn_on_robot::Cmd_Send_Timer_Callback()
{
  double vx = 0.0;
  double vy = 0.0;
  double wz = 0.0;
  const auto now = this->get_clock()->now();

  if(has_received_cmd)
  {
    const double age = (now - last_cmd_time).seconds();
    if(age <= cmd_timeout_sec)
    {
      vx = current_linear_x;
      vy = current_linear_y;
      wz = current_angular_z;
    }
  }

  if(velocity_nonzero(vx, vy, wz, brake_trigger_threshold))
  {
    if(!motion_active)
    {
      motion_start_time = now;
    }
    motion_active = true;
    braking_active = false;
    last_motion_linear_x = vx;
    last_motion_linear_y = vy;
    last_motion_angular_z = wz;
    Send_Cmd_Frame(vx, vy, wz);
    return;
  }

  double motion_duration_sec = 0.0;
  if(motion_active)
  {
    motion_duration_sec = (now - motion_start_time).seconds();
    motion_active = false;
  }

  if(braking_active)
  {
    if(now < brake_end_time)
    {
      Send_Cmd_Frame(brake_linear_x, brake_linear_y, brake_angular_z);
      return;
    }
    braking_active = false;
  }

  if(brake_enable &&
     brake_ratio > 0.0 &&
     brake_duration_sec > 0.0 &&
     motion_duration_sec >= brake_min_motion_sec &&
     velocity_nonzero(last_motion_linear_x, last_motion_linear_y, last_motion_angular_z, brake_trigger_threshold))
  {
    double effective_brake_duration = brake_duration_sec;
    if(brake_duration_gain > 0.0)
    {
      effective_brake_duration = std::min(brake_duration_sec, motion_duration_sec * brake_duration_gain);
    }
    brake_linear_x = clamp_double(-last_motion_linear_x * brake_ratio, -max_linear_x, max_linear_x);
    brake_linear_y = clamp_double(-last_motion_linear_y * brake_ratio, -max_linear_y, max_linear_y);
    brake_angular_z = clamp_double(-last_motion_angular_z * brake_ratio, -max_angular_z, max_angular_z);
    brake_end_time = now + rclcpp::Duration::from_nanoseconds(
        static_cast<int64_t>(effective_brake_duration * 1000000000.0));
    braking_active = true;
    last_motion_linear_x = 0.0;
    last_motion_linear_y = 0.0;
    last_motion_angular_z = 0.0;
    Send_Cmd_Frame(brake_linear_x, brake_linear_y, brake_angular_z);
    return;
  }

  last_motion_linear_x = 0.0;
  last_motion_linear_y = 0.0;
  last_motion_angular_z = 0.0;
  Send_Cmd_Frame(vx, vy, wz);
}

void turn_on_robot::Send_Cmd_Frame(double linear_x, double linear_y, double angular_z)
{
  short transition;

  Send_Data.tx[0]=FRAME_HEADER;
  Send_Data.tx[1] = AutoRecharge;
  Send_Data.tx[2] = SecurityPLY;

  transition = static_cast<short>(linear_x * 1000.0);
  Send_Data.tx[4] = transition;
  Send_Data.tx[3] = transition>>8;

  transition = static_cast<short>(linear_y * 1000.0);
  Send_Data.tx[6] = transition;
  Send_Data.tx[5] = transition>>8;

  transition = static_cast<short>(angular_z * 1000.0);
  Send_Data.tx[8] = transition;
  Send_Data.tx[7] = transition>>8;

  Send_Data.tx[9]=Check_Sum(9,SEND_DATA_CHECK);
  Send_Data.tx[10]=FRAME_TAIL;

  if(!Stm32_Serial.isOpen())
  {
    return;
  }

  try
  {
    Stm32_Serial.write(Send_Data.tx,sizeof (Send_Data.tx));
  }
  catch (serial::IOException& e)
  {
    RCLCPP_ERROR(this->get_logger(),("Unable to send data through serial port"));
  }
}

/**
 * @brief 机械臂控制命令回调函数
 *
 * @param arm_cmd_msg 包含机械臂控制数据的消息，data[0-2]为三个关节角度，data[3]为夹爪状态
 *
 * 该函数接收机械臂控制指令，检测关节角度和夹爪状态的变化，
 * 将控制数据转换为串口通信协议格式后，通过串口发送给STM32下位机。
 * 仅当控制数据发生显著变化时（角度变化>0.01度或夹爪状态改变）才发送数据。
 */
void turn_on_robot::arm_cmd_Callback(const std_msgs::msg::Float32MultiArray arm_cmd_msg)
{
  //  printf("joint_states_Callback \n");
       if(fabs(last_A-arm_cmd_msg.data[0])>0.01||
        fabs(last_B-arm_cmd_msg.data[1])>0.01||
        fabs(last_C-arm_cmd_msg.data[2])>0.01||
           last_grap!=arm_cmd_msg.data[3] )
      {
        last_A=arm_cmd_msg.data[0];
        last_B=arm_cmd_msg.data[1];
        last_C=arm_cmd_msg.data[2];
        last_grap=arm_cmd_msg.data[3];
      }
      else return;
      Send_Data.tx[0]=0xAA;
      Send_Data.tx[1]=((short)(arm_cmd_msg.data[0]*1000))>>8;
      Send_Data.tx[2]=(short)(arm_cmd_msg.data[0]*1000);


      Send_Data.tx[3]=((short)(arm_cmd_msg.data[1]*1000))>>8;
      Send_Data.tx[4]=(short)(arm_cmd_msg.data[1]*1000);

      Send_Data.tx[5]=((short)(arm_cmd_msg.data[2]*1000))>>8;
      Send_Data.tx[6]=(short)(arm_cmd_msg.data[2]*1000);

      Send_Data.tx[7]=(uint8_t)arm_cmd_msg.data[3];
      Send_Data.tx[8]=Check_Sum(8,SEND_DATA_CHECK);
      Send_Data.tx[9]=0xBB;
 

  try
  {

    // for(uint8_t i=0;i<11;i++)
    //         {
    //             printf("%x ",Send_Data.tx[i]);
    //         }
    //         printf("\n");
  // ROS_INFO("%x-%x-%x-%x-%x-%x-%x-%x-%x-%x-%x",
  // Send_Data.tx[0],Send_Data.tx[1],Send_Data.tx[2],Send_Data.tx[3],Send_Data.tx[4],Send_Data.tx[5],Send_Data.tx[6],Send_Data.tx[7],
  // Send_Data.tx[8],Send_Data.tx[9],Send_Data.tx[10]);

  Stm32_Serial.write(Send_Data.tx,sizeof (Send_Data.tx)); //向串口发数据
  //ROS_INFO_STREAM("New control command");//显示受到了新的控制指令  
  }
  catch (serial::IOException& e)
  {
    RCLCPP_ERROR(this->get_logger(),("Unable to send data through serial port")); //If sending data fails, an error message is printed //如果发送数据失败，打印错误信息
  }

}


/**************************************
Date: January 28, 2021
Function: Publish the IMU data topic
功能: 发布IMU数据话题
***************************************/
void turn_on_robot::Publish_ImuSensor()
{
  sensor_msgs::msg::Imu Imu_Data_Pub; //Instantiate IMU topic data //实例化IMU话题数据
  Imu_Data_Pub.header.stamp = rclcpp::Node::now(); 
  Imu_Data_Pub.header.frame_id = gyro_frame_id; //IMU corresponds to TF coordinates, which is required to use the robot_pose_ekf feature pack 
                                                //IMU对应TF坐标，使用robot_pose_ekf功能包需要设置此项
  Imu_Data_Pub.orientation.x = Mpu6050.orientation.x; //A quaternion represents a three-axis attitude //四元数表达三轴姿态
  Imu_Data_Pub.orientation.y = Mpu6050.orientation.y; 
  Imu_Data_Pub.orientation.z = Mpu6050.orientation.z;
  Imu_Data_Pub.orientation.w = Mpu6050.orientation.w;
  Imu_Data_Pub.orientation_covariance[0] = 1e6; //Three-axis attitude covariance matrix //三轴姿态协方差矩阵
  Imu_Data_Pub.orientation_covariance[4] = 1e6;
  Imu_Data_Pub.orientation_covariance[8] = 1e-6; //tues
  Imu_Data_Pub.angular_velocity.x = Mpu6050.angular_velocity.x; //Triaxial angular velocity //三轴角速度
  Imu_Data_Pub.angular_velocity.y = Mpu6050.angular_velocity.y;
  Imu_Data_Pub.angular_velocity.z = Mpu6050.angular_velocity.z;
  Imu_Data_Pub.angular_velocity_covariance[0] = 1e6; //Triaxial angular velocity covariance matrix //三轴角速度协方差矩阵
  Imu_Data_Pub.angular_velocity_covariance[4] = 1e6;
  Imu_Data_Pub.angular_velocity_covariance[8] = 1e-6; //tues
  Imu_Data_Pub.linear_acceleration.x = Mpu6050.linear_acceleration.x; //Triaxial acceleration //三轴线性加速度
  Imu_Data_Pub.linear_acceleration.y = Mpu6050.linear_acceleration.y; 
  Imu_Data_Pub.linear_acceleration.z = Mpu6050.linear_acceleration.z;  
  imu_publisher->publish(Imu_Data_Pub); //Pub IMU topic //发布IMU话题
}
/**************************************
Date: January 28, 2021
Function: Publish the odometer topic, Contains position, attitude, triaxial velocity, angular velocity about triaxial, TF parent-child coordinates, and covariance matrix
功能: 发布里程计话题，包含位置、姿态、三轴速度、绕三轴角速度、TF父子坐标、协方差矩阵
***************************************/
void turn_on_robot::Publish_Odom()
{
    //Convert the Z-axis rotation Angle into a quaternion for expression 
    //把Z轴转角转换为四元数进行表达
    tf2::Quaternion q;
    q.setRPY(0,0,Robot_Pos.Z);
    geometry_msgs::msg::Quaternion odom_quat=tf2::toMsg(q);
    
    nav_msgs::msg::Odometry odom; //Instance the odometer topic data //实例化里程计话题数据
    odom.header.stamp = rclcpp::Node::now(); ; 
    odom.header.frame_id = odom_frame_id; // Odometer TF parent coordinates //里程计TF父坐标
    odom.pose.pose.position.x = Robot_Pos.X; //Position //位置
    odom.pose.pose.position.y = Robot_Pos.Y;
    odom.pose.pose.position.z = Robot_Pos.Z;
    odom.pose.pose.orientation = odom_quat; //Posture, Quaternion converted by Z-axis rotation //姿态，通过Z轴转角转换的四元数

    odom.child_frame_id = robot_frame_id; // Odometer TF subcoordinates //里程计TF子坐标
    odom.twist.twist.linear.x =  Robot_Vel.X; //Speed in the X direction //X方向速度
    odom.twist.twist.linear.y =  Robot_Vel.Y; //Speed in the Y direction //Y方向速度
    odom.twist.twist.angular.z = Robot_Vel.Z; //Angular velocity around the Z axis //绕Z轴角速度 

    //There are two types of this matrix, which are used when the robot is at rest and when it is moving.Extended Kalman Filtering officially provides 2 matrices for the robot_pose_ekf feature pack
    //这个矩阵有两种，分别在机器人静止和运动的时候使用。扩展卡尔曼滤波官方提供的2个矩阵，用于robot_pose_ekf功能包
    if(Robot_Vel.X== 0&&Robot_Vel.Y== 0&&Robot_Vel.Z== 0)
      //If the velocity is zero, it means that the error of the encoder will be relatively small, and the data of the encoder will be considered more reliable
      //如果velocity是零，说明编码器的误差会比较小，认为编码器数据更可靠
      memcpy(&odom.pose.covariance, odom_pose_covariance2, sizeof(odom_pose_covariance2)),
      memcpy(&odom.twist.covariance, odom_twist_covariance2, sizeof(odom_twist_covariance2));
    else
      //If the velocity of the trolley is non-zero, considering the sliding error that may be brought by the encoder in motion, the data of IMU is considered to be more reliable
      //如果小车velocity非零，考虑到运动中编码器可能带来的滑动误差，认为imu的数据更可靠
      memcpy(&odom.pose.covariance, odom_pose_covariance, sizeof(odom_pose_covariance)),
      memcpy(&odom.twist.covariance, odom_twist_covariance, sizeof(odom_twist_covariance));       
    odom_publisher->publish(odom); //Pub odometer topic //发布里程计话题
}
/**************************************
Date: January 28, 2021
Function: Publish voltage-related information
功能: 发布电压相关信息
***************************************/
void turn_on_robot::Publish_Voltage()
{
    std_msgs::msg::Float32 voltage_msgs; //Define the data type of the power supply voltage publishing topic //定义电源电压发布话题的数据类型
    static float Count_Voltage_Pub=0;
    if(Count_Voltage_Pub++>10)
      {
        Count_Voltage_Pub=0;  
        voltage_msgs.data = Power_voltage; //The power supply voltage is obtained //电源供电的电压获取
        voltage_publisher->publish(voltage_msgs); //Post the power supply voltage topic unit: V, volt //发布电源电压话题单位：V、伏特
      }
}

////////// 回充发布与回调 ////////
/**************************************
Date: January 17, 2022
Function: Pub the topic whether the robot finds the infrared signal (charging station)
功能: 发布机器人是否寻找到红外信号(充电桩)的话题
***************************************/
void turn_on_robot::Publish_RED()
{
    std_msgs::msg::UInt8 msg;
    msg.data=Red;
    RED_publisher->publish(msg); 

}
/**************************************
Date: January 14, 2022
Function: Publish a topic about whether the robot is charging
功能: 发布机器人是否在充电的话题
***************************************/
void turn_on_robot::Publish_Charging()
{
    static bool last_charging;
    std_msgs::msg::Bool msg;
    msg.data=Charging;
    Charging_publisher->publish(msg); 
    if(last_charging==false && Charging==true)cout<<GREEN<<"Robot is charging."<<endl<<RESET;
    if(last_charging==true && Charging==false)cout<<RED  <<"Robot charging has disconnected."<<endl<<RESET;
    last_charging=Charging;

    //发布底层回充的设置状态
    msg.data=charge_set_state;
    ChargingMode_publisher->publish(msg);

}
/**************************************
Date: January 28, 2021
Function: Publish charging current information
功能: 发布充电电流信息
***************************************/
void turn_on_robot::Publish_ChargingCurrent()
{
    std_msgs::msg::Float32 msg; 
    msg.data=Charging_Current;
    Charging_current_publisher->publish(msg);
}

void turn_on_robot::RangerAvoidFlag_Callback(const std_msgs::msg::Bool::SharedPtr AvoidFlag)
{
  //设置避障标志位
  ranger_avoid_flag = AvoidFlag->data;
  if(  ranger_avoid_flag ) cout<<"避障已开启"<<endl;
  else cout<<"避障已关闭"<<endl;
}
/**************************************
Date: 
Function: 
功能: 发布超声波测量距离相关信息
***************************************/
void turn_on_robot::Publish_distance()
{
  // robot_interfaces::msg::Supersonic distance_msg;
  // distance_msg.header.stamp=rclcpp::Node::now();;

  // //mini没有超声波F
  // if(car_mode=="S300_Mini" || car_mode=="S300_Mini_without_lebai") distance.F = 0;

  // if(distance.A>=0||distance.A<=6) distance_msg.distance_a = distance.A;
  // if(distance.B>=0||distance.B<=6) distance_msg.distance_b = distance.B;
  // if(distance.C>=0||distance.C<=6) distance_msg.distance_c = distance.C;
  // if(distance.D>=0||distance.D<=6) distance_msg.distance_d = distance.D;
  // if(distance.E>=0||distance.E<=6) distance_msg.distance_e = distance.E;
  // if(distance.F>=0||distance.F<=6) distance_msg.distance_f = distance.F;
  // if(distance.G>=0||distance.G<=6) distance_msg.distance_g = distance.G;
  // if(distance.H>=0||distance.H<=6) distance_msg.distance_h = distance.H;
  // distance_publisher->publish(distance_msg);

  // //发送自检数据话题
  // std_msgs::msg::UInt32 msg; 
  // msg.data = temp_selfcheck;
  // SelfCheck_publisher->publish(msg);

    // 超声波传感器数据
    sensor_msgs::msg::Range range_msg;
    range_msg.header.stamp = this->get_clock()->now(); // 使用节点时钟获取时间戳
    range_msg.radiation_type = sensor_msgs::msg::Range::ULTRASOUND; // 数据类型为超声波
    range_msg.field_of_view = 0.52; // 视场角，约30°
    range_msg.min_range = 0.02; // 2cm 盲区
    range_msg.max_range = 5.3; // 5米最远距离

    // 发布 rangerA
    range_msg.header.frame_id = "ultrasonic_data_A";
    range_msg.range = distanceA;
    range_a_publisher_->publish(range_msg);

    // 发布 rangerB
    range_msg.header.frame_id = "ultrasonic_data_B";
    range_msg.range = distanceB;
    range_b_publisher_->publish(range_msg);

    // 发布 rangerC
    range_msg.header.frame_id = "ultrasonic_data_C";
    range_msg.range = distanceC;
    range_c_publisher_->publish(range_msg);

    // 发布 rangerD
    range_msg.header.frame_id = "ultrasonic_data_D";
    range_msg.range = distanceD;
    range_d_publisher_->publish(range_msg);

    // 发布 rangerE
    range_msg.header.frame_id = "ultrasonic_data_E";
    range_msg.range = distanceE;
    range_e_publisher_->publish(range_msg);

    // 发布 rangerF
    range_msg.header.frame_id = "ultrasonic_data_F";
    range_msg.range = distanceF;
    range_f_publisher_->publish(range_msg);
}

/**************************************
Date: January 14, 2022
Function: Subscription robot recharge flag bit topic, used to tell the lower machine speed command is normal command or recharge command
功能: 订阅机器人是否回充标志位话题，用于告诉下位机速度命令是正常命令还是回充命令
***************************************/
void turn_on_robot::Recharge_Flag_Callback(const std_msgs::msg::Int8::SharedPtr Recharge_Flag)
{
  //设置自动回充标志位
  AutoRecharge=Recharge_Flag->data;
  
  //新版本协议
  Send_Data.tx[0] = FRAME_HEADER; //frame head 0x7B //帧头0X7B
  Send_Data.tx[1] = 1;

  if( AutoRecharge!=0 ) Send_Data.tx[2] = 0xA1;
  else Send_Data.tx[2] = 0xA0;
  
  Send_Data.tx[3] = 0;Send_Data.tx[4] = 0;
  Send_Data.tx[5] = 0;Send_Data.tx[6] = 0;
  Send_Data.tx[7] = 0;Send_Data.tx[8] = 0;
  Send_Data.tx[9]=Check_Sum(9,SEND_DATA_CHECK); //For the BCC check bits, see the Check_Sum function //BCC校验位，规则参见Check_Sum函数
  Send_Data.tx[10]=FRAME_TAIL; //frame tail 0x7D //帧尾0X7D
  try
  {
    Stm32_Serial.write(Send_Data.tx,sizeof (Send_Data.tx)); //Sends data to the downloader via serial port //通过串口向下位机发送数据 
  }
  catch (...)   
  {
    RCLCPP_ERROR(this->get_logger(),("Unable to send data through serial port")); //If sending data fails, an error message is printed //如果发送数据失败，打印错误信息
  }

  //旧版本协议
  if( AutoRecharge==0 )
  {
    Send_Data.tx[0] = FRAME_HEADER; //frame head 0x7B //帧头0X7B
    Send_Data.tx[1] = AutoRecharge; //set aside //预留位
    Send_Data.tx[2] = 0; //set aside //预留位
    Send_Data.tx[3] = 0;Send_Data.tx[4] = 0;
    Send_Data.tx[5] = 0;Send_Data.tx[6] = 0;
    Send_Data.tx[7] = 0;Send_Data.tx[8] = 0;
    Send_Data.tx[9]=Check_Sum(9,SEND_DATA_CHECK); //For the BCC check bits, see the Check_Sum function //BCC校验位，规则参见Check_Sum函数
    Send_Data.tx[10]=FRAME_TAIL; //frame tail 0x7D //帧尾0X7D
    try
    {
      Stm32_Serial.write(Send_Data.tx,sizeof (Send_Data.tx)); //Sends data to the downloader via serial port //通过串口向下位机发送数据 
    }
    catch (...)   
    {
      RCLCPP_ERROR(this->get_logger(),("Unable to send data through serial port")); //If sending data fails, an error message is printed //如果发送数据失败，打印错误信息
    }
  }

}

//底盘安全开启或关闭的标志位
void turn_on_robot::Security_Callback(const std_msgs::msg::Int8 &Security_Flag)
{
  SecurityPLY = Security_Flag.data;

  //新版本协议
  Send_Data.tx[0] = FRAME_HEADER; //frame head 0x7B //帧头0X7B
  Send_Data.tx[1] = 0;

  if( SecurityPLY!=0 ) Send_Data.tx[2] = 0xB1;
  else Send_Data.tx[2] = 0xB0;
  
  Send_Data.tx[3] = 0;Send_Data.tx[4] = 0;
  Send_Data.tx[5] = 0;Send_Data.tx[6] = 0;
  Send_Data.tx[7] = 0;Send_Data.tx[8] = 0;
  Send_Data.tx[9]=Check_Sum(9,SEND_DATA_CHECK); //For the BCC check bits, see the Check_Sum function //BCC校验位，规则参见Check_Sum函数
  Send_Data.tx[10]=FRAME_TAIL; //frame tail 0x7D //帧尾0X7D
  try
  {
    Stm32_Serial.write(Send_Data.tx,sizeof (Send_Data.tx)); //Sends data to the downloader via serial port //通过串口向下位机发送数据 
  }
  catch (...)   
  {
    RCLCPP_ERROR(this->get_logger(),("Unable to send data through serial port")); //If sending data fails, an error message is printed //如果发送数据失败，打印错误信息
  }

  //旧版本协议
  Send_Data.tx[0] = FRAME_HEADER; //frame head 0x7B //帧头0X7B
  Send_Data.tx[1] = 0; //set aside //预留位
  Send_Data.tx[2] = SecurityPLY; //set aside //预留位
  Send_Data.tx[3] = 0;Send_Data.tx[4] = 0;
  Send_Data.tx[5] = 0;Send_Data.tx[6] = 0;
  Send_Data.tx[7] = 0;Send_Data.tx[8] = 0;
  Send_Data.tx[9]=Check_Sum(9,SEND_DATA_CHECK); //For the BCC check bits, see the Check_Sum function //BCC校验位，规则参见Check_Sum函数
  Send_Data.tx[10]=FRAME_TAIL; //frame tail 0x7D //帧尾0X7D
  try
  {
    Stm32_Serial.write(Send_Data.tx,sizeof (Send_Data.tx)); //Sends data to the downloader via serial port //通过串口向下位机发送数据 
  }
  catch (...)   
  {
    RCLCPP_ERROR(this->get_logger(),("Unable to send data through serial port")); //If sending data fails, an error message is printed //如果发送数据失败，打印错误信息
  }
}


// //服务
// void turn_on_robot::Set_Charge_Callback(const shared_ptr<turtlesim::srv::Spawn::Request> req,shared_ptr<turtlesim::srv::Spawn::Response> res)
// {
//     //以服务方式开启回充
//     auto msg = std::make_shared<std_msgs::msg::Int8>();
//     msg->data = round(req->x);
//     Recharge_Flag_Callback(msg);

//     if( msg->data==0 )
//     {
//       if(charge_set_state==0)
//         AutoRecharge=0,res->name = "true";
//       else
//         res->name = "false";
//     }
//     else
//     {
//       if(charge_set_state==1)
//         res->name = "true";
//       else
//         res->name = "false";
//     }
//     return;
// }
////////// 回充发布与回调 ////////

/**************************************
Date: January 28, 2021
Function: Serial port communication check function, packet n has a byte, the NTH -1 byte is the check bit, the NTH byte bit frame end.Bit XOR results from byte 1 to byte n-2 are compared with byte n-1, which is a BCC check
Input parameter: Count_Number: Check the first few bytes of the packet
功能: 串口通讯校验函数，数据包n有个字节，第n-1个字节为校验位，第n个字节位帧尾。第1个字节到第n-2个字节数据按位异或的结果与第n-1个字节对比，即为BCC校验
输入参数： Count_Number：数据包前几个字节加入校验   mode：对发送数据还是接收数据进行校验
***************************************/
unsigned char turn_on_robot::Check_Sum(unsigned char Count_Number,unsigned char mode)
{
  unsigned char check_sum=0,k;
  
  if(mode==0) //Receive data mode //接收数据模式
  {
   for(k=0;k<Count_Number;k++)
    {
     check_sum=check_sum^Receive_Data.rx[k]; //By bit or by bit //按位异或
     }
  }
  if(mode==1) //Send data mode //发送数据模式
  {
   for(k=0;k<Count_Number;k++)
    {
     check_sum=check_sum^Send_Data.tx[k]; //By bit or by bit //按位异或
     }
  }
  return check_sum; //Returns the bitwise XOR result //返回按位异或结果
}

//自动回充专用校验位
unsigned char turn_on_robot::Check_Sum_AutoCharge(unsigned char Count_Number,unsigned char mode)
{
  unsigned char check_sum=0,k;
  if(mode==0) //Receive data mode //接收数据模式
  {
   for(k=0;k<Count_Number;k++)
    {
     check_sum=check_sum^Receive_AutoCharge_Data.rx[k]; //By bit or by bit //按位异或
    }
  }

  return check_sum;
}


/**************************************
Date: November 18, 2021
Function: Read and verify the data sent by the lower computer frame by frame through the serial port, and then convert the data into international units
功能: 通过串口读取并逐帧校验下位机发送过来的数据，然后数据转换为国际单位
***************************************/
bool turn_on_robot::Get_Sensor_Data_New()
{
  short transition_16=0; //Intermediate variable //中间变量
  uint8_t check=0,check2=0,check3=0, error=1,error2=1,error3=1,Receive_Data_Pr[1]; //Temporary variable to save the data of the lower machine //临时变量，保存下位机数据
  static int count,count2,count3; //Static variable for counting //静态变量，用于计数
  static uint8_t Last_Receive;
  Stm32_Serial.read(Receive_Data_Pr,sizeof(Receive_Data_Pr)); //Read the data sent by the lower computer through the serial port //通过串口读取下位机发送过来的数据

  Receive_Data.rx[count] = Receive_Data_Pr[0]; //Fill the array with serial data //串口数据填入数组
  Receive_AutoCharge_Data.rx[count3] = Receive_Data_Pr[0];
  Distance_Data.rx[count2] = Receive_Data_Pr[0];

  Receive_Data.Frame_Header = Receive_Data.rx[0]; //The first part of the data is the frame header 0X7B //数据的第一位是帧头0X7B
  Receive_Data.Frame_Tail = Receive_Data.rx[23];  //The last bit of data is frame tail 0X7D //数据的最后一位是帧尾0X7D

  //基础数据包接收( 7F 7B 或 7D 7B )
  if( ((Last_Receive==AutoCharge_TAIL || Last_Receive==FRAME_TAIL ) && Receive_Data_Pr[0] == FRAME_HEADER) || 
        count>0 )
    count++;
  else
    count=0;

  //自动回充数据包接收(FC 7C 或 7D 7C)
  if( ((Last_Receive==Distance_TAIL || Last_Receive==FRAME_TAIL ) && Receive_Data_Pr[0] == AutoCharge_HEADER) || 
        count3>0 )
    count3++;
  else
    count3=0;

  //超声波数据接收( 7D FA )
  if( (Last_Receive==FRAME_TAIL && Receive_Data_Pr[0] == Distance_HEADER) || 
        count2>0 )
    count2++;
  else
    count2=0;

  Last_Receive = Receive_Data_Pr[0]; //保存本次接收到的数据

  //自动回充数据处理
  if(count3 == AutoCharge_DATA_SIZE)
  {
    count3=0;
    if(Receive_AutoCharge_Data.rx[AutoCharge_DATA_SIZE-1]==AutoCharge_TAIL) //确认帧尾   
    {
      check3 =  Check_Sum_AutoCharge(6,0);//校验位计算    
      if(check3 == Receive_AutoCharge_Data.rx[AutoCharge_DATA_SIZE-2]) //校验正确
      {
        error3=0;
      }
      if(error3 == 0)  //校验正确开始赋值
      {
        transition_16 = 0;
        transition_16   |=  Receive_AutoCharge_Data.rx[1]<<8;
        transition_16   |=  Receive_AutoCharge_Data.rx[2]; 
        Charging_Current = transition_16/1000+(transition_16 % 1000)*0.001; //充电电流 
        
        Red =  Receive_AutoCharge_Data.rx[3];    //红外接受状态
        Charging = Receive_AutoCharge_Data.rx[4];//小车充电状态
        charge_set_state = Receive_AutoCharge_Data.rx[5];
        check_AutoCharge_data = true; //数据成功接收标志位
      }
    }
  }

  //超声波数据
  if(count2 == Distance_DATA_size)
  {
    count2 = 0;
    if(Distance_Data.rx[Distance_DATA_size-1]==Distance_TAIL)
    {
      check2 = Calculate_BCC(Distance_Data.rx,17);
      if(check2 == Distance_Data.rx[Distance_DATA_size-2])
      {
        error2=0;
      }
      if(error2==0)
      {
        distanceA = ((short)((Distance_Data.rx[1]<<8) |(Distance_Data.rx[2] )))/1000.0f;
        distanceB = ((short)((Distance_Data.rx[3]<<8) |(Distance_Data.rx[4] )))/1000.0f;
        distanceC = ((short)((Distance_Data.rx[5]<<8) |(Distance_Data.rx[6] )))/1000.0f;
        distanceD = ((short)((Distance_Data.rx[7]<<8) |(Distance_Data.rx[8] )))/1000.0f;
        distanceE = ((short)((Distance_Data.rx[9]<<8) |(Distance_Data.rx[10])))/1000.0f;
        distanceF = ((short)((Distance_Data.rx[11]<<8)|(Distance_Data.rx[12])))/1000.0f;
        distanceG = 0;
        distanceH = 0;
        //自检数据
        //temp_selfcheck = (uint32_t)(Distance_Data.rx[13]<<24|Distance_Data.rx[14]<<16|Distance_Data.rx[15]<<8|Distance_Data.rx[16]);
        // distance.G = ((short)((Distance_Data.rx[13]<<8)|(Distance_Data.rx[14])))/1000.0f;
        // distance.H = ((short)((Distance_Data.rx[15]<<8)|(Distance_Data.rx[16])))/1000.0f;
        distance_flag=true;
      }
    }
  }


  if(count == 24) //Verify the length of the packet //验证数据包的长度
  {
    count=0;  //Prepare for the serial port data to be refill into the array //为串口数据重新填入数组做准备
    if(Receive_Data.Frame_Tail == FRAME_TAIL) //Verify the frame tail of the packet //验证数据包的帧尾
    {
      check=Check_Sum(22,READ_DATA_CHECK);  //BCC check passes or two packets are interlaced //BCC校验通过或者两组数据包交错

      if(check == Receive_Data.rx[22])  
      {
        error=0;  //XOR bit check successful //异或位校验成功
      }
      if(error == 0)
      {
        /*//Check receive_data.rx for debugging use //查看Receive_Data.rx，调试使用 
        ROS_INFO("%x-%x-%x-%x-%x-%x-%x-%x-%x-%x-%x-%x-%x-%x-%x-%x-%x-%x-%x-%x-%x-%x-%x-%x",
        Receive_Data.rx[0],Receive_Data.rx[1],Receive_Data.rx[2],Receive_Data.rx[3],Receive_Data.rx[4],Receive_Data.rx[5],Receive_Data.rx[6],Receive_Data.rx[7],
        Receive_Data.rx[8],Receive_Data.rx[9],Receive_Data.rx[10],Receive_Data.rx[11],Receive_Data.rx[12],Receive_Data.rx[13],Receive_Data.rx[14],Receive_Data.rx[15],
        Receive_Data.rx[16],Receive_Data.rx[17],Receive_Data.rx[18],Receive_Data.rx[19],Receive_Data.rx[20],Receive_Data.rx[21],Receive_Data.rx[22],Receive_Data.rx[23]); 
        */

        Receive_Data.Flag_Stop=Receive_Data.rx[1]; //set aside //预留位
        Robot_Vel.X = Odom_Trans(Receive_Data.rx[2],Receive_Data.rx[3]); //Get the speed of the moving chassis in the X direction //获取运动底盘X方向速度
          
        Robot_Vel.Y = Odom_Trans(Receive_Data.rx[4],Receive_Data.rx[5]); //Get the speed of the moving chassis in the Y direction, The Y speed is only valid in the omnidirectional mobile robot chassis
                                                                          //获取运动底盘Y方向速度，Y速度仅在全向移动机器人底盘有效
        Robot_Vel.Z = Odom_Trans(Receive_Data.rx[6],Receive_Data.rx[7]); //Get the speed of the moving chassis in the Z direction //获取运动底盘Z方向速度   
          
        //MPU6050 stands for IMU only and does not refer to a specific model. It can be either MPU6050 or MPU9250
        //Mpu6050仅代表IMU，不指代特定型号，既可以是MPU6050也可以是MPU9250
        Mpu6050_Data.accele_x_data = IMU_Trans(Receive_Data.rx[8],Receive_Data.rx[9]);   //Get the X-axis acceleration of the IMU     //获取IMU的X轴加速度  
        Mpu6050_Data.accele_y_data = IMU_Trans(Receive_Data.rx[10],Receive_Data.rx[11]); //Get the Y-axis acceleration of the IMU     //获取IMU的Y轴加速度
        Mpu6050_Data.accele_z_data = IMU_Trans(Receive_Data.rx[12],Receive_Data.rx[13]); //Get the Z-axis acceleration of the IMU     //获取IMU的Z轴加速度
        Mpu6050_Data.gyros_x_data = IMU_Trans(Receive_Data.rx[14],Receive_Data.rx[15]);  //Get the X-axis angular velocity of the IMU //获取IMU的X轴角速度  
        Mpu6050_Data.gyros_y_data = IMU_Trans(Receive_Data.rx[16],Receive_Data.rx[17]);  //Get the Y-axis angular velocity of the IMU //获取IMU的Y轴角速度  
        Mpu6050_Data.gyros_z_data = IMU_Trans(Receive_Data.rx[18],Receive_Data.rx[19]);  //Get the Z-axis angular velocity of the IMU //获取IMU的Z轴角速度  
        //Linear acceleration unit conversion is related to the range of IMU initialization of STM32, where the range is ±2g=19.6m/s^2
        //线性加速度单位转化，和STM32的IMU初始化的时候的量程有关,这里量程±2g=19.6m/s^2
        Mpu6050.linear_acceleration.x = Mpu6050_Data.accele_x_data / ACCEl_RATIO;
        Mpu6050.linear_acceleration.y = Mpu6050_Data.accele_y_data / ACCEl_RATIO;
        Mpu6050.linear_acceleration.z = Mpu6050_Data.accele_z_data / ACCEl_RATIO;
        //The gyroscope unit conversion is related to the range of STM32's IMU when initialized. Here, the range of IMU's gyroscope is ±500°/s
        //Because the robot generally has a slow Z-axis speed, reducing the range can improve the accuracy
        //陀螺仪单位转化，和STM32的IMU初始化的时候的量程有关，这里IMU的陀螺仪的量程是±500°/s
        //因为机器人一般Z轴速度不快，降低量程可以提高精度
        Mpu6050.angular_velocity.x =  Mpu6050_Data.gyros_x_data * GYROSCOPE_RATIO;
        Mpu6050.angular_velocity.y =  Mpu6050_Data.gyros_y_data * GYROSCOPE_RATIO;
        Mpu6050.angular_velocity.z =  Mpu6050_Data.gyros_z_data * GYROSCOPE_RATIO;

        //Get the battery voltage
        //获取电池电压
        transition_16 = 0;
        transition_16 |=  Receive_Data.rx[20]<<8;
        transition_16 |=  Receive_Data.rx[21];  
        Power_voltage = transition_16/1000+(transition_16 % 1000)*0.001; //Unit conversion millivolt(mv)->volt(v) //单位转换毫伏(mv)->伏(v)
          
        return true;
      }
    }
  }
  return false;
}
/**************************************
Date: January 28, 2021
Function: Loop access to the lower computer data and issue topics
功能: 循环获取下位机数据与发布话题
***************************************/
void turn_on_robot::Control()
{
  //_Last_Time = ros::Time::now();
  _Last_Time = rclcpp::Node::now();
  while(rclcpp::ok())
  {
    try
    {
    //_Now = ros::Time::now();
    _Now = rclcpp::Node::now();
    Sampling_Time = (_Now - _Last_Time).seconds();  //Retrieves time interval, which is used to integrate velocity to obtain displacement (mileage) 
                                                 //获取时间间隔，用于积分速度获得位移(里程) 
    if (true == Get_Sensor_Data_New()) //The serial port reads and verifies the data sent by the lower computer, and then the data is converted to international units
                                   //通过串口读取并校验下位机发送过来的数据，然后数据转换为国际单位
    {
      //Odometer error correction //里程计误差修正
      Robot_Vel.X = Robot_Vel.X*odom_x_scale;
      Robot_Vel.Y = Robot_Vel.Y*odom_y_scale;
      if( Robot_Vel.Z>=0 )
        Robot_Vel.Z = Robot_Vel.Z*odom_z_scale_positive;
      else
        Robot_Vel.Z = Robot_Vel.Z*odom_z_scale_negative;

      Robot_Pos.X+=(Robot_Vel.X * cos(Robot_Pos.Z) - Robot_Vel.Y * sin(Robot_Pos.Z)) * Sampling_Time; //Calculate the displacement in the X direction, unit: m //计算X方向的位移，单位：m
      Robot_Pos.Y+=(Robot_Vel.X * sin(Robot_Pos.Z) + Robot_Vel.Y * cos(Robot_Pos.Z)) * Sampling_Time; //Calculate the displacement in the Y direction, unit: m //计算Y方向的位移，单位：m
      Robot_Pos.Z+=Robot_Vel.Z * Sampling_Time; //The angular displacement about the Z axis, in rad //绕Z轴的角位移，单位：rad 

      //Calculate the three-axis attitude from the IMU with the angular velocity around the three-axis and the three-axis acceleration
      //通过IMU绕三轴角速度与三轴加速度计算三轴姿态
      Quaternion_Solution(Mpu6050.angular_velocity.x, Mpu6050.angular_velocity.y, Mpu6050.angular_velocity.z,\
                Mpu6050.linear_acceleration.x, Mpu6050.linear_acceleration.y, Mpu6050.linear_acceleration.z);

      Publish_Odom();      //Pub the speedometer topic //发布里程计话题
      Publish_ImuSensor(); //Pub the IMU topic //发布IMU话题    
      Publish_Voltage();   //Pub the topic of power supply voltage //发布电源电压话题

      _Last_Time = _Now; //Record the time and use it to calculate the time interval //记录时间，用于计算时间间隔
      
    }
    
    //自动回充数据话题
    if(check_AutoCharge_data)
    {
      Publish_Charging();  //Pub a topic about whether the robot is charging //发布机器人是否在充电的话题
      Publish_RED();       //Pub the topic whether the robot finds the infrared signal (charging station) //发布机器人是否寻找到红外信号(充电桩)的话题
      Publish_ChargingCurrent(); //Pub the charging current topic //发布充电电流话题
      check_AutoCharge_data = false;
    }

    //超声波数据
    if(distance_flag==true)  
    {
        Publish_distance();  //发布超声波数据
        distance_flag = false;
    }

    rclcpp::spin_some(this->get_node_base_interface());   //The loop waits for the callback function //循环等待回调函数
    }
    
    catch (const rclcpp::exceptions::RCLError & e )
  {
  RCLCPP_ERROR(this->get_logger(),"unexpectedly failed whith %s",e.what()); 
  }
}
}
/**************************************
Date: January 28, 2021
Function: Constructor, executed only once, for initialization
功能: 构造函数, 只执行一次，用于初始化
***************************************/
turn_on_robot::turn_on_robot():rclcpp::Node ("wheeltec_robot")
{
  Sampling_Time=0;
  Power_voltage=0;
  //Clear the data
  //清空数据
  memset(&Robot_Pos, 0, sizeof(Robot_Pos));
  memset(&Robot_Vel, 0, sizeof(Robot_Vel));
  memset(&Receive_Data, 0, sizeof(Receive_Data)); 
  memset(&Send_Data, 0, sizeof(Send_Data));
  memset(&Mpu6050_Data, 0, sizeof(Mpu6050_Data));

  //ros::NodeHandle private_nh("~"); //Create a node handle //创建节点句柄
  //The private_nh.param() entry parameter corresponds to the initial value of the name of the parameter variable on the parameter server
  //private_nh.param()入口参数分别对应：参数服务器上的名称  参数变量名  初始值
  
  this->declare_parameter<int>("serial_baud_rate",115200);
  this->declare_parameter<double>("send_rate_hz",50.0);
  this->declare_parameter<double>("cmd_timeout_sec",0.25);
  this->declare_parameter<double>("max_linear_x",0.45);
  this->declare_parameter<double>("max_linear_y",0.0);
  this->declare_parameter<double>("max_angular_z",2.4);
  this->declare_parameter<bool>("brake_enable",true);
  this->declare_parameter<double>("brake_ratio",1.0);
  this->declare_parameter<double>("brake_duration_sec",0.5);
  this->declare_parameter<double>("brake_trigger_threshold",0.02);
  this->declare_parameter<double>("brake_duration_gain",1.0);
  this->declare_parameter<double>("brake_min_motion_sec",0.12);
  this->declare_parameter<bool>("ranger_avoid_flag",0);
  this->declare_parameter<bool>("ultrasonic_avoid",0);

  this->declare_parameter<std::string>("usart_port_name", "/dev/wheeltec_controller");
  this->declare_parameter<std::string>("odom_frame_id", "odom");
  this->declare_parameter<std::string>("robot_frame_id", "base_footprint");
  this->declare_parameter<std::string>("gyro_frame_id", "gyro_link");
  this->declare_parameter<std::string>("car_mode", "mini_mec");
  this->declare_parameter<double>("odom_x_scale",1.0);
  this->declare_parameter<double>("odom_y_scale",1.0);
  this->declare_parameter<double>("odom_z_scale_positive",1.0);
  this->declare_parameter<double>("odom_z_scale_negative",1.0);

  this->get_parameter("ranger_avoid_flag", ranger_avoid_flag);
  this->get_parameter("ultrasonic_avoid", ultrasonic_avoid);

  
  this->get_parameter("serial_baud_rate", serial_baud_rate);//Communicate baud rate 115200 to the lower machine //和下位机通信波特率115200
  this->get_parameter("usart_port_name", usart_port_name);//Fixed serial port number //固定串口号
  this->get_parameter("odom_frame_id", odom_frame_id);//The odometer topic corresponds to the parent TF coordinate //里程计话题对应父TF坐标
  this->get_parameter("robot_frame_id", robot_frame_id);//The odometer topic corresponds to sub-TF coordinates //里程计话题对应子TF坐标
  this->get_parameter("gyro_frame_id", gyro_frame_id);//IMU topics correspond to TF coordinates //IMU话题对应TF坐标
  this->get_parameter("car_mode", car_mode);
  this->get_parameter("send_rate_hz", send_rate_hz);
  this->get_parameter("cmd_timeout_sec", cmd_timeout_sec);
  this->get_parameter("max_linear_x", max_linear_x);
  this->get_parameter("max_linear_y", max_linear_y);
  this->get_parameter("max_angular_z", max_angular_z);
  this->get_parameter("brake_enable", brake_enable);
  this->get_parameter("brake_ratio", brake_ratio);
  this->get_parameter("brake_duration_sec", brake_duration_sec);
  this->get_parameter("brake_trigger_threshold", brake_trigger_threshold);
  this->get_parameter("brake_duration_gain", brake_duration_gain);
  this->get_parameter("brake_min_motion_sec", brake_min_motion_sec);
  this->get_parameter("odom_x_scale", odom_x_scale);
  this->get_parameter("odom_y_scale", odom_y_scale);
  this->get_parameter("odom_z_scale_positive", odom_z_scale_positive);
  this->get_parameter("odom_z_scale_negative", odom_z_scale_negative);

  //将car_mode转换为小写，便于后续判断车型模式
  std::transform(car_mode.begin(), car_mode.end(), car_mode.begin(),
                [](unsigned char c) { return std::tolower(c); });
                
  odom_publisher = create_publisher<nav_msgs::msg::Odometry>("odom", 2);//Create the odometer topic publisher //创建里程计话题发布者
  imu_publisher = create_publisher<sensor_msgs::msg::Imu>("imu/data_raw", 2); //Create an IMU topic publisher //创建IMU话题发布者
  voltage_publisher = create_publisher<std_msgs::msg::Float32>("PowerVoltage", 1);//Create a battery-voltage topic publisher //创建电池电压话题发布者

  //回充发布者
  Charging_publisher = create_publisher<std_msgs::msg::Bool>("robot_charging_flag", 10);
  Charging_current_publisher = create_publisher<std_msgs::msg::Float32>("robot_charging_current", 10);
  RED_publisher = create_publisher<std_msgs::msg::UInt8>("robot_red_flag", 10);
  ChargingMode_publisher = create_publisher<std_msgs::msg::Bool>("robot_charging_mode", 1);

  //超声波发布者
  range_a_publisher_ = create_publisher<sensor_msgs::msg::Range>("ultrasonic_data_A", 10);
  range_b_publisher_ = create_publisher<sensor_msgs::msg::Range>("ultrasonic_data_B", 10);
  range_c_publisher_ = create_publisher<sensor_msgs::msg::Range>("ultrasonic_data_C", 10);
  range_d_publisher_ = create_publisher<sensor_msgs::msg::Range>("ultrasonic_data_D", 10);
  range_e_publisher_ = create_publisher<sensor_msgs::msg::Range>("ultrasonic_data_E", 10);
  range_f_publisher_ = create_publisher<sensor_msgs::msg::Range>("ultrasonic_data_F", 10);

  //回充订阅者
  Recharge_Flag_Sub = create_subscription<std_msgs::msg::Int8>(
      "robot_recharge_flag", 10, std::bind(&turn_on_robot::Recharge_Flag_Callback, this,std::placeholders::_1));
  //回充服务提供
  //SetCharge_Service=this->create_service<turtlesim::srv::Spawn>("/set_charge",std::bind(&turn_on_robot::Set_Charge_Callback,this,std::placeholders::_1 ,std::placeholders::_2));
  arm_cmd_Sub = create_subscription<std_msgs::msg::Float32MultiArray>(
        "arm_cmd", 10, std::bind(&turn_on_robot::arm_cmd_Callback, this,std::placeholders::_1));
  SetRgb_Sub = create_subscription<std_msgs::msg::UInt8MultiArray>(
      "set_rgb_color", 5, std::bind(&turn_on_robot::Set_LightRgb_Callback, this,std::placeholders::_1));
  
  //Set the velocity control command callback function
  //速度控制命令订阅回调函数设置
  /*if(ultrasonic_avoid == 1) 
  {
    cmd_vel="/cmd_vel_avoid";
    RCLCPP_INFO(this->get_logger(),"wheeltec_robot use ultrasonic avoid");
  }
  else {
    cmd_vel="/cmd_vel";
    RCLCPP_INFO(this->get_logger(),"wheeltec_robot not use ultrasonic avoid");

  }
  */
  
  Cmd_Vel_Sub = create_subscription<geometry_msgs::msg::Twist>(
      "/cmd_vel", 2, std::bind(&turn_on_robot::Cmd_Vel_Callback, this, _1));

  AvoidFlag_Sub = create_subscription<std_msgs::msg::Bool>(
      "RangerAvoidFlag", 10, std::bind(&turn_on_robot::RangerAvoidFlag_Callback, this, _1));

  //底盘安全防护关闭话题订阅
  Security_Sub = create_subscription<std_msgs::msg::Int8>("chassis_security",2, std::bind(&turn_on_robot::Security_Callback, this,std::placeholders::_1));

  RCLCPP_INFO(this->get_logger(),"wheeltec_robot Data ready"); //Prompt message //提示信息

  try
  { 
    //Attempts to initialize and open the serial port //尝试初始化与开启串口
    Stm32_Serial.setPort(usart_port_name); //Select the serial port number to enable //选择要开启的串口号
    Stm32_Serial.setBaudrate(serial_baud_rate); //Set the baud rate //设置波特率
    serial::Timeout _time = serial::Timeout::simpleTimeout(2000); //Timeout //超时等待
    Stm32_Serial.setTimeout(_time);
    Stm32_Serial.open(); //Open the serial port //开启串口
    Stm32_Serial.flushInput();
  }
  catch (serial::IOException& e)
  {
    RCLCPP_ERROR(this->get_logger(),"wheeltec_robot can not open serial port,Please check the serial port cable! "); //If opening the serial port fails, an error message is printed //如果开启串口失败，打印错误信息
  } 
  if(Stm32_Serial.isOpen())
  {
    RCLCPP_INFO(this->get_logger(),"wheeltec_robot serial port opened"); //Serial port opened successfully //串口开启成功提示
  }
  last_cmd_time = this->get_clock()->now();
  if(send_rate_hz <= 0.0)
  {
    send_rate_hz = 50.0;
  }
  auto send_period = std::chrono::duration<double>(1.0 / send_rate_hz);
  cmd_send_timer_ = this->create_wall_timer(
      std::chrono::duration_cast<std::chrono::nanoseconds>(send_period),
      std::bind(&turn_on_robot::Cmd_Send_Timer_Callback, this));
  RCLCPP_INFO(this->get_logger(),
      "cmd watchdog enabled: send_rate=%.2fHz timeout=%.3fs max_vx=%.3f max_vy=%.3f max_wz=%.3f",
      send_rate_hz, cmd_timeout_sec, max_linear_x, max_linear_y, max_angular_z);
  RCLCPP_INFO(this->get_logger(),
      "brake pulse: enable=%d ratio=%.3f max_duration=%.3fs gain=%.3f min_motion=%.3fs threshold=%.3f",
      brake_enable, brake_ratio, brake_duration_sec, brake_duration_gain,
      brake_min_motion_sec, brake_trigger_threshold);
}
/**************************************
Date: January 28, 2021
Function: Destructor, executed only once and called by the system when an object ends its life cycle
功能: 析构函数，只执行一次，当对象结束其生命周期时系统会调用这个函数
***************************************/
turn_on_robot::~turn_on_robot()
{
  for(int i=0; i<10; ++i)
  {
    Send_Cmd_Frame(0.0, 0.0, 0.0);
    usleep(10000);
  }

  //Sends the stop motion command to the lower machine before the turn_on_robot object ends
  //对象turn_on_robot结束前向下位机发送停止运动命令
  Send_Data.tx[0]=FRAME_HEADER;
  Send_Data.tx[1] = 0;  
  Send_Data.tx[2] = 0; 

  //The target velocity of the X-axis of the robot //机器人X轴的目标线速度 
  Send_Data.tx[4] = 0;     
  Send_Data.tx[3] = 0;  

  //The target velocity of the Y-axis of the robot //机器人Y轴的目标线速度 
  Send_Data.tx[6] = 0;
  Send_Data.tx[5] = 0;  

  //The target velocity of the Z-axis of the robot //机器人Z轴的目标角速度 
  Send_Data.tx[8] = 0;  
  Send_Data.tx[7] = 0;    
  Send_Data.tx[9]=Check_Sum(9,SEND_DATA_CHECK); //Check the bits for the Check_Sum function //校验位，规则参见Check_Sum函数
  Send_Data.tx[10]=FRAME_TAIL; 
  try
  {
    Stm32_Serial.write(Send_Data.tx,sizeof (Send_Data.tx)); //Send data to the serial port //向串口发数据  
  }
  catch (serial::IOException& e)   
  {
    RCLCPP_ERROR(this->get_logger(),"Unable to send data through serial port"); //If sending data fails, an error message is printed //如果发送数据失败,打印错误信息
  }

  // Sends the stop motion command to the lower machine before the turn_on_robot object ends
  // 对象turn_on_robot结束前向下位机发送停止运动命令
  Send_Data.tx[0]=0xAA;
  Send_Data.tx[1] = 0;  
  Send_Data.tx[2] = 0; 


  Send_Data.tx[3]=((short)(1.5707*1000))>>8;
  Send_Data.tx[4]=(short)(1.5707*1000);

  Send_Data.tx[5]=((short)(0.3917*1000))>>8;
  Send_Data.tx[6]=(short)(0.3917*1000);
 
  //The target velocity of the Z-axis of the robot //机器人Z轴的目标角速度 
  Send_Data.tx[7] = 0;    
  Send_Data.tx[8]=Check_Sum(8,SEND_DATA_CHECK); //Check the bits for the Check_Sum function //校验位，规则参见Check_Sum函数
  Send_Data.tx[9]=0xBB; 

  try
  {
    Stm32_Serial.write(Send_Data.tx,sizeof (Send_Data.tx)); //Send data to the serial port //向串口发数据  
  }
  catch (serial::IOException& e)   
  {
    RCLCPP_ERROR(this->get_logger(),"Unable to send data through serial port"); //If sending data fails, an error message is printed //如果发送数据失败,打印错误信息
  }

  Stm32_Serial.close(); //Close the serial port //关闭串口  
  RCLCPP_INFO(this->get_logger(),"Shutting down"); //Prompt message //提示信息
}
