RickSanchezC5163/spacemit-k1-edge-ai-risk-robot/ros2_ws/src/turn_on_wheeltec_robot/include/turn_on_wheeltec_robot/wheeltec_robot.h

#ifndef __WHEELTEC_ROBOT_H_
#define __WHEELTEC_ROBOT_H_

#include <iostream>
#include <algorithm>
#include <chrono>
#include <functional>
#include <string.h>
#include <string> 
#include <iostream>
#include <math.h> 
#include <stdlib.h>    
#include <unistd.h> 

#include "rclcpp/rclcpp.hpp"
#include <rcl/types.h>
#include <sys/stat.h>
#include <fcntl.h>          
#include <stdbool.h>
      
#include <sys/types.h>

#include <serial/serial.h>


#include <tf2_ros/transform_broadcaster.h>
#include "tf2_geometry_msgs/tf2_geometry_msgs.hpp"

#include "std_msgs/msg/string.hpp"
#include <std_msgs/msg/float32.hpp>
#include <nav_msgs/msg/odometry.hpp>
#include <geometry_msgs/msg/pose.hpp>
#include <geometry_msgs/msg/vector3.hpp>
#include <sensor_msgs/msg/imu.hpp>
#include "wheeltec_robot_msg/msg/data.hpp" 
#include "wheeltec_robot_msg/msg/supersonic.hpp"
#include <std_msgs/msg/u_int8_multi_array.hpp>
#include <std_msgs/msg/float32_multi_array.hpp>

//回充相关新增
#include <std_msgs/msg/int8.hpp>
#include <std_msgs/msg/bool.hpp>
#include <std_msgs/msg/u_int8.hpp>

//超声波数据
#include <sensor_msgs/msg/range.hpp>

using namespace std;

#define RESET   string("\033[0m")
#define RED     "\033[31m"
#define GREEN   "\033[32m"
#define YELLOW  "\033[33m"
#define BLUE    "\033[34m"
#define PURPLE  "\033[35m"
#define CYAN    "\033[36m"

//Macro definition
//宏定义
#define SEND_DATA_CHECK   1          //Send data check flag bits //发送数据校验标志位
#define READ_DATA_CHECK   0          //Receive data to check flag bits //接收数据校验标志位
#define FRAME_HEADER      0X7B       //Frame head //帧头
#define FRAME_TAIL        0X7D       //Frame tail //帧尾
#define RECEIVE_DATA_SIZE 24         //The length of the data sent by the lower computer //下位机发送过来的数据的长度
#define SEND_DATA_SIZE    11         //The length of data sent by ROS to the lower machine //ROS向下位机发送的数据的长度
#define PI 				  3.1415926f //PI //圆周率
// 超声波测量距离相关变量
#define Distance_DATA_size 19
#define Distance_HEADER    0XFA //Frame_header //帧头
#define Distance_TAIL      0XFC //Frame_tail   //帧尾

//自动回充相关
#define AutoCharge_HEADER      0X7C //Frame_header //自动回充数据帧头
#define AutoCharge_TAIL        0X7F //Frame_tail   //自动回充数据帧尾
#define AutoCharge_DATA_SIZE    8   //下位机发送过来的自动回充数据的长度

//Relative to the range set by the IMU gyroscope, the range is ±500°, corresponding data range is ±32768
//The gyroscope raw data is converted in radian (rad) units, 1/65.5/57.30=0.00026644
//与IMU陀螺仪设置的量程有关，量程±500°，对应数据范围±32768
//陀螺仪原始数据转换位弧度(rad)单位，1/65.5/57.30=0.00026644
#define GYROSCOPE_RATIO   0.00026644f
//Relates to the range set by the IMU accelerometer, range is ±2g, corresponding data range is ±32768
//Accelerometer original data conversion bit m/s^2 units, 32768/2g=32768/19.6=1671.84	
//与IMU加速度计设置的量程有关，量程±2g，对应数据范围±32768
//加速度计原始数据转换位m/s^2单位，32768/2g=32768/19.6=1671.84
#define ACCEl_RATIO 	  1671.84f  	

//extern sensor_msgs::msg::Imu Mpu6050;  //External variables, IMU topic data //外部变量，IMU话题数据

//Covariance matrix for speedometer topic data for robt_pose_ekf feature pack
//协方差矩阵，用于里程计话题数据，用于robt_pose_ekf功能包
const double odom_pose_covariance[36]   = {1e-3,    0,    0,   0,   0,    0, 
										      0, 1e-3,    0,   0,   0,    0,
										      0,    0,  1e6,   0,   0,    0,
										      0,    0,    0, 1e6,   0,    0,
										      0,    0,    0,   0, 1e6,    0,
										      0,    0,    0,   0,   0,  1e3 };

const double odom_pose_covariance2[36]  = {1e-9,    0,    0,   0,   0,    0, 
										      0, 1e-3, 1e-9,   0,   0,    0,
										      0,    0,  1e6,   0,   0,    0,
										      0,    0,    0, 1e6,   0,    0,
										      0,    0,    0,   0, 1e6,    0,
										      0,    0,    0,   0,   0, 1e-9 };

const double odom_twist_covariance[36]  = {1e-3,    0,    0,   0,   0,    0, 
										      0, 1e-3,    0,   0,   0,    0,
										      0,    0,  1e6,   0,   0,    0,
										      0,    0,    0, 1e6,   0,    0,
										      0,    0,    0,   0, 1e6,    0,
										      0,    0,    0,   0,   0,  1e3 };
										      
const double odom_twist_covariance2[36] = {1e-9,    0,    0,   0,   0,    0, 
										      0, 1e-3, 1e-9,   0,   0,    0,
										      0,    0,  1e6,   0,   0,    0,
										      0,    0,    0, 1e6,   0,    0,
										      0,    0,    0,   0, 1e6,    0,
										      0,    0,    0,   0,   0, 1e-9} ;

//Data structure for speed and position
//速度、位置数据结构体
typedef struct __Vel_Pos_Data_
{
	float X;
	float Y;
	float Z;
}Vel_Pos_Data;

//IMU data structure
//IMU数据结构体
typedef struct __MPU6050_DATA_
{
	short accele_x_data; 
	short accele_y_data; 	
	short accele_z_data; 
    short gyros_x_data; 
	short gyros_y_data; 	
	short gyros_z_data; 

}MPU6050_DATA;

//The structure of the ROS to send data to the down machine
//ROS向下位机发送数据的结构体
typedef struct _SEND_DATA_  
{
	    uint8_t tx[SEND_DATA_SIZE];
		float X_speed;	       
		float Y_speed;           
		float Z_speed;         
		unsigned char Frame_Tail; 
}SEND_DATA;
//下位机发送的自动回充相关数据结构体
typedef struct _RECEIVE_AutoCharge_DATA_     
{
	    uint8_t rx[AutoCharge_HEADER];  //8字节
		unsigned char Frame_Header;     //帧头
		unsigned char Frame_Tail;		//帧尾
}RECEIVE_AutoCharge_DATA;
//下位机发送的超声波相关数据结构体
//下位机向ROS发送的超声波数据结构体
typedef struct _DISTANCE_DATA_     
{
	    uint8_t rx[Distance_DATA_size];
		unsigned char Frame_Header;
		unsigned char Frame_Tail;
}DISTANCE_DATA;

typedef struct _Distance_     
{
	float A;  
	float B;  
	float C;  
	float D;
	float E;  
	float F;
 	float G;  
	float H;
}Supersonic_data;

//The structure in which the lower computer sends data to the ROS
//下位机向ROS发送数据的结构体
typedef struct _RECEIVE_DATA_     
{
	    uint8_t rx[RECEIVE_DATA_SIZE];
	    uint8_t Flag_Stop;
		unsigned char Frame_Header;
		float X_speed;  
		float Y_speed;  
		float Z_speed;  
		float Power_Voltage;	
		unsigned char Frame_Tail;
}RECEIVE_DATA;

//The robot chassis class uses constructors to initialize data, publish topics, etc
//机器人底盘类，使用构造函数初始化数据和发布话题等
class turn_on_robot : public rclcpp::Node
{
	public:
		turn_on_robot();  //Constructor //构造函数
		~turn_on_robot(); //Destructor //析构函数
		void Control();   //Loop control code //循环控制代码
		serial::Serial Stm32_Serial; //Declare a serial object //声明串口对象 
	private:
		//ros::NodeHandle n;           //Create a ROS node handle //创建ROS节点句柄
		rclcpp::Time _Now, _Last_Time;  //Time dependent, used for integration to find displacement (mileage) //时间相关，用于积分求位移(里程)
		float Sampling_Time;         //Sampling time, used for integration to find displacement (mileage) //采样时间，用于积分求位移(里程)
		rclcpp::Subscription<std_msgs::msg::Float32MultiArray>::SharedPtr arm_cmd_Sub;

		rclcpp::Subscription<geometry_msgs::msg::Twist>::SharedPtr Cmd_Vel_Sub;//Initialize the topic subscriber //初始化话题订阅者
   
		rclcpp::TimerBase::SharedPtr cmd_send_timer_;
		rclcpp::Subscription<std_msgs::msg::Bool>::SharedPtr AvoidFlag_Sub;

        //Initialize the topic publisher //初始化话题发布者
        rclcpp::Publisher<nav_msgs::msg::Odometry>::SharedPtr odom_publisher;       
        rclcpp::Publisher<std_msgs::msg::Float32>::SharedPtr voltage_publisher;        
        rclcpp::Publisher<sensor_msgs::msg::Imu>::SharedPtr imu_publisher;
        rclcpp::Publisher<wheeltec_robot_msg::msg::Supersonic>::SharedPtr distance_publisher;         

		//超声波发布者
		rclcpp::Publisher<sensor_msgs::msg::Range>::SharedPtr range_a_publisher_;
		rclcpp::Publisher<sensor_msgs::msg::Range>::SharedPtr range_b_publisher_;
		rclcpp::Publisher<sensor_msgs::msg::Range>::SharedPtr range_c_publisher_;
		rclcpp::Publisher<sensor_msgs::msg::Range>::SharedPtr range_d_publisher_;
		rclcpp::Publisher<sensor_msgs::msg::Range>::SharedPtr range_e_publisher_;
		rclcpp::Publisher<sensor_msgs::msg::Range>::SharedPtr range_f_publisher_;

		//回充相关发布者
		rclcpp::Publisher<std_msgs::msg::Bool>::SharedPtr Charging_publisher;
		rclcpp::Publisher<std_msgs::msg::Float32>::SharedPtr Charging_current_publisher;
		rclcpp::Publisher<std_msgs::msg::UInt8>::SharedPtr RED_publisher;
		rclcpp::Publisher<std_msgs::msg::Bool>::SharedPtr ChargingMode_publisher;
		
		//回充相关订阅者
		rclcpp::Subscription<geometry_msgs::msg::Twist>::SharedPtr Red_Vel_Sub;
		rclcpp::Subscription<std_msgs::msg::Int8>::SharedPtr Recharge_Flag_Sub;
		//回充相关服务
		//底盘安全等级设置
		rclcpp::Subscription<std_msgs::msg::Int8>::SharedPtr Security_Sub;
		//灯带设置
		rclcpp::Subscription<std_msgs::msg::UInt8MultiArray>::SharedPtr SetRgb_Sub;
		//The speed topic subscribes to the callback function
		//速度话题订阅回调函数
        void Cmd_Vel_Callback(const geometry_msgs::msg::Twist::SharedPtr twist_aux);
		void Cmd_Send_Timer_Callback();
		void Send_Cmd_Frame(double linear_x, double linear_y, double angular_z);
        void arm_cmd_Callback(const std_msgs::msg::Float32MultiArray arm_joint);
		void RangerAvoidFlag_Callback(const std_msgs::msg::Bool::SharedPtr AvoidFlag);
		//避障处理函数
		geometry_msgs::msg::Twist avoid_obstacle(const geometry_msgs::msg::Twist& twist);
		//回充相关回调函数
		void Red_Vel_Callback(const geometry_msgs::msg::Twist::SharedPtr twist_aux); 
		void Recharge_Flag_Callback(const std_msgs::msg::Int8::SharedPtr Recharge_Flag); 

		//底盘安全等级回调函数
		void Security_Callback(const std_msgs::msg::Int8 &Security_Flag);
    void Set_LightRgb_Callback(const std_msgs::msg::UInt8MultiArray::SharedPtr msg);
		//回充相关发布函数
		void Publish_Charging();       
		void Publish_ChargingCurrent();
		void Publish_RED();

		void Publish_Odom();      //Pub the speedometer topic //发布里程计话题
		void Publish_ImuSensor(); //Pub the IMU sensor topic //发布IMU传感器话题
		void Publish_Voltage();   //Pub the power supply voltage topic //发布电源电压话题
		void Publish_distance();//发布超声波距离
        //从串口(ttyUSB)读取运动底盘速度、IMU、电源电压数据
        //Read motion chassis speed, IMU, power supply voltage data from serial port (ttyUSB)
        bool Get_Sensor_Data();   
		bool Get_Sensor_Data_New(); 
        unsigned char Check_Sum(unsigned char Count_Number,unsigned char mode); //BBC check function //BBC校验函数
        unsigned char Check_Sum_AutoCharge(unsigned char Count_Number,unsigned char mode); //BBC check function //BBC校验函数
        short IMU_Trans(uint8_t Data_High,uint8_t Data_Low);  //IMU data conversion read //IMU数据转化读取
		float Odom_Trans(uint8_t Data_High,uint8_t Data_Low); //Odometer data is converted to read //里程计数据转化读取

		string car_mode;
        string usart_port_name, robot_frame_id, gyro_frame_id, odom_frame_id; //Define the related variables //定义相关变量
		string cmd_vel;
		bool ranger_avoid_flag,ultrasonic_avoid;
		bool has_received_cmd=false;
		bool braking_active=false;
		rclcpp::Time last_cmd_time;
		rclcpp::Time brake_end_time;
		double current_linear_x=0.0;
		double current_linear_y=0.0;
		double current_angular_z=0.0;
		double last_motion_linear_x=0.0;
		double last_motion_linear_y=0.0;
		double last_motion_angular_z=0.0;
		double brake_linear_x=0.0;
		double brake_linear_y=0.0;
		double brake_angular_z=0.0;
		double send_rate_hz=50.0;
		double cmd_timeout_sec=0.25;
		double max_linear_x=0.45;
		double max_linear_y=0.0;
		double max_angular_z=2.4;
		bool brake_enable=true;
		double brake_ratio=1.0;
		double brake_duration_sec=0.5;
		double brake_trigger_threshold=0.02;
		double brake_duration_gain=1.0;
		double brake_min_motion_sec=0.12;
		bool motion_active=false;
		rclcpp::Time motion_start_time;
        int serial_baud_rate;      //Serial communication baud rate //串口通信波特率
        RECEIVE_DATA Receive_Data; //The serial port receives the data structure //串口接收数据结构体
        SEND_DATA Send_Data;       //The serial port sends the data structure //串口发送数据结构体
        DISTANCE_DATA Distance_Data; //超声波数据
        RECEIVE_AutoCharge_DATA Receive_AutoCharge_Data;  //串口接收自动回充数据结构体
        Supersonic_data distance;  //超声波距离对象
        Vel_Pos_Data Robot_Pos;    //The position of the robot //机器人的位置
        Vel_Pos_Data Robot_Vel;    //The speed of the robot //机器人的速度
        MPU6050_DATA Mpu6050_Data; //IMU data //IMU数据

		int8_t AutoRecharge=0;
        float Power_voltage;       //Power supply voltage //电源电压
        bool Charging=0;           //Whether the robot is charging the flag bit //机器人是否在充电的标志位
        float Charging_Current=0;  //Charging_Current //充电电流
        uint8_t Red=0;                //Whether the robot finds the marker bit of infrared signal (charging pile)  //机器人是否寻找到红外信号(充电桩)的标志位 
        float odom_x_scale,odom_y_scale,odom_z_scale_positive,odom_z_scale_negative; //Odometer correction parameters //里程计修正参数
};
#endif
