RickSanchezC5163/spacemit-k1-edge-ai-risk-robot/tools/run_prelim_remote_mapping_yolo_arm_demo.py

#!/usr/bin/env python3
"""Preliminary remote-mapping demo bridge.

This runner is the thin integration layer for the preliminary competition demo:

manual/remote guarded mapping is launched separately, while this node subscribes
to D435 RGB/depth/camera_info and odom, runs local YOLO, deduplicates visual
risk events, publishes alarms, writes map-point evidence, and generates a
manual/remote arm no-load response candidate.

It never publishes cmd_vel, never starts chassis motion, and never starts the
arm by itself. The operator decides when and where to run the no-load arm
response after positioning the robot by remote control.
"""

from __future__ import annotations

import argparse
import json
import math
import sys
import time
from collections import OrderedDict
from datetime import datetime, timezone
from pathlib import Path
from typing import Any, Dict, List, Optional, Sequence, Tuple

import numpy as np
import rclpy
import rclpy.duration
import rclpy.time
from nav_msgs.msg import Odometry
from rclpy.executors import ExternalShutdownException
from rclpy.node import Node
from sensor_msgs.msg import CameraInfo, Image
from std_msgs.msg import String
from tf2_ros import Buffer, TransformException, TransformListener


ROOT = Path(__file__).resolve().parents[1]
if str(ROOT) not in sys.path:
    sys.path.insert(0, str(ROOT))

from tools.d435_capture_once import (  # noqa: E402
    camera_info_to_dict,
    canonical_rgb,
    depth_to_meters,
    image_msg_to_array,
    odom_to_dict,
    save_depth_vis_png,
    save_rgb_png,
)
from tools.run_k1_d435_yolo_realtime_display import (  # noqa: E402
    resolve_model_input_size,
    run_inference,
    select_ort_providers,
)
from tools.mission_state import MissionStateStore  # noqa: E402
from tools.risk_spatial_memory import (  # noqa: E402
    PoseSample,
    PoseSampleCache,
    RiskFusionTracker,
    Transform2D,
    project_risk_to_map,
)


DEFAULT_MODEL = "models/risk_vision/yolov8n_320_q_truncated_balanced.onnx"
DEFAULT_OUTPUT_DIR = "outputs/prelim_remote_mapping_yolo_arm_demo_v1"
PROTOCOL_VERSION = "prelim_remote_mapping_yolo_arm_demo_v1"

CAMERA_OFFSET_BASE_M = (0.105, 0.0, 0.11)
AXIS_MAPPING = "d435_optical_to_base_approx:z_forward_to_x_forward,x_right_to_y_right"

CLASS_TO_EVENT = {
    "crack": ("hard_obstacle", "high", "stop_and_report"),
    "corrosion": ("hard_obstacle", "medium", "stop_and_recheck"),
    "leakage": ("hard_obstacle", "high", "stop_and_report"),
    "blockage": ("blocked_path", "high", "approach_then_arm_candidate"),
}

DEFAULT_AUTO_RISK_GATES_SPEC = (
    "crack:0.60:0.20:1.20,corrosion:0.60:0.20:1.20,"
    "leakage:0.60:0.20:1.20,blockage:0.60:0.20:1.20"
)
DEFAULT_APPROACH_RISK_GATES_SPEC = (
    "crack:0.15:0.20:1.20,corrosion:0.15:0.20:1.20,"
    "leakage:0.15:0.20:1.20,blockage:0.15:0.20:1.20"
)

COLORS = {
    "crack": (40, 40, 255),
    "corrosion": (0, 160, 255),
    "leakage": (255, 120, 0),
    "blockage": (255, 0, 220),
}


def now_iso() -> str:
    return datetime.now(timezone.utc).isoformat(timespec="milliseconds")


def now_id() -> str:
    return datetime.now(timezone.utc).strftime("%Y%m%dT%H%M%S%fZ")[:-4]


def write_json(path: Path, data: Any) -> None:
    path.parent.mkdir(parents=True, exist_ok=True)
    path.write_text(json.dumps(data, ensure_ascii=False, indent=2) + "\n", encoding="utf-8")


def append_jsonl(path: Path, data: Any) -> None:
    path.parent.mkdir(parents=True, exist_ok=True)
    with path.open("a", encoding="utf-8") as handle:
        handle.write(json.dumps(data, ensure_ascii=False, sort_keys=True) + "\n")


def write_text(path: Path, text: str) -> None:
    path.parent.mkdir(parents=True, exist_ok=True)
    path.write_text(text, encoding="utf-8")


def yaw_from_odom_dict(odom: Dict[str, Any]) -> Optional[float]:
    try:
        return float((odom.get("pose") or {}).get("yaw_rad"))
    except (TypeError, ValueError):
        return None


def camera_point_to_base_point(camera_point: Dict[str, float]) -> Dict[str, float]:
    # D435 optical frame: x right, y down, z forward.
    return {
        "x": round(float(camera_point["z"]) + CAMERA_OFFSET_BASE_M[0], 4),
        "y": round(-float(camera_point["x"]) + CAMERA_OFFSET_BASE_M[1], 4),
        "z": round(-float(camera_point["y"]) + CAMERA_OFFSET_BASE_M[2], 4),
    }


def base_point_to_odom_xy(base_point: Dict[str, float], odom: Dict[str, Any]) -> Optional[Dict[str, float]]:
    pose = odom.get("pose") or {}
    position = pose.get("position") or {}
    yaw = yaw_from_odom_dict(odom)
    if yaw is None:
        return None
    try:
        robot_x = float(position["x"])
        robot_y = float(position["y"])
        base_x = float(base_point["x"])
        base_y = float(base_point["y"])
    except (KeyError, TypeError, ValueError):
        return None
    cos_y = math.cos(yaw)
    sin_y = math.sin(yaw)
    return {
        "x": round(robot_x + base_x * cos_y - base_y * sin_y, 4),
        "y": round(robot_y + base_x * sin_y + base_y * cos_y, 4),
    }


def yaw_from_quat_xyzw(x: float, y: float, z: float, w: float) -> float:
    return math.atan2(2.0 * (w * z + x * y), 1.0 - 2.0 * (y * y + z * z))


def transform_xy_with_tf(x: float, y: float, transform: Any) -> Dict[str, float]:
    trans = transform.transform.translation
    rot = transform.transform.rotation
    yaw = yaw_from_quat_xyzw(float(rot.x), float(rot.y), float(rot.z), float(rot.w))
    cos_y = math.cos(yaw)
    sin_y = math.sin(yaw)
    return {
        "x": round(float(trans.x) + x * cos_y - y * sin_y, 4),
        "y": round(float(trans.y) + x * sin_y + y * cos_y, 4),
        "source_frame": transform.header.frame_id,
        "target_child_frame": transform.child_frame_id,
        "tf_yaw_rad": round(yaw, 6),
    }


def transform_2d_from_tf(transform: Any) -> Transform2D:
    trans = transform.transform.translation
    rot = transform.transform.rotation
    return Transform2D(
        x=float(trans.x),
        y=float(trans.y),
        yaw=yaw_from_quat_xyzw(float(rot.x), float(rot.y), float(rot.z), float(rot.w)),
    )


def transform_2d_from_odom(odom: Dict[str, Any]) -> Optional[Transform2D]:
    pose = odom.get("pose") or {}
    position = pose.get("position") or {}
    yaw = yaw_from_odom_dict(odom)
    if yaw is None:
        return None
    try:
        return Transform2D(float(position["x"]), float(position["y"]), float(yaw))
    except (KeyError, TypeError, ValueError):
        return None


def camera_intrinsics(camera_info: Dict[str, Any]) -> Optional[Tuple[float, float, float, float]]:
    values = camera_info.get("k") or camera_info.get("K")
    if isinstance(values, list) and len(values) >= 9:
        return float(values[0]), float(values[4]), float(values[2]), float(values[5])
    return None


def localize_bbox_in_memory(
    bbox_xywh: Sequence[float],
    depth_m: np.ndarray,
    camera_info: Dict[str, Any],
    min_depth_m: float,
    max_depth_m: float,
) -> Dict[str, Any]:
    if len(bbox_xywh) < 4:
        return {"depth_status": "invalid", "reason": "bbox missing"}
    intrinsics = camera_intrinsics(camera_info)
    if intrinsics is None:
        return {"depth_status": "missing", "reason": "camera intrinsics missing"}
    fx, fy, cx, cy = intrinsics
    if fx == 0.0 or fy == 0.0:
        return {"depth_status": "invalid", "reason": "camera intrinsics invalid"}

    height, width = depth_m.shape[:2]
    x, y, w, h = [int(round(float(value))) for value in bbox_xywh[:4]]
    if w <= 0 or h <= 0:
        return {"depth_status": "invalid", "reason": "bbox width/height invalid"}
    x0 = max(0, min(width - 1, x))
    y0 = max(0, min(height - 1, y))
    x1 = max(0, min(width, x + w))
    y1 = max(0, min(height, y + h))
    if x1 <= x0 or y1 <= y0:
        return {"depth_status": "invalid", "reason": "bbox outside depth image"}

    roi = depth_m[y0:y1, x0:x1]
    finite = np.isfinite(roi)
    valid = roi[finite & (roi >= float(min_depth_m)) & (roi <= float(max_depth_m))]
    if valid.size == 0:
        return {
            "bbox_xywh": list(bbox_xywh[:4]),
            "depth_median_m": None,
            "bbox_valid_depth_ratio": 0.0,
            "camera_point_xyz_m": None,
            "depth_status": "invalid",
            "reason": "no valid depth in bbox",
        }

    depth_median = float(np.median(valid))
    center_u = (x0 + x1 - 1) / 2.0
    center_v = (y0 + y1 - 1) / 2.0
    x_m = (center_u - cx) * depth_median / fx
    y_m = (center_v - cy) * depth_median / fy
    return {
        "bbox_xywh": list(bbox_xywh[:4]),
        "depth_median_m": round(depth_median, 4),
        "bbox_valid_depth_ratio": round(float(valid.size) / float(roi.size), 4),
        "camera_point_xyz_m": {
            "x": round(float(x_m), 4),
            "y": round(float(y_m), 4),
            "z": round(float(depth_median), 4),
        },
        "depth_status": "valid",
        "claim_boundary": [
            "D435 bbox depth localization is approximate unless TF and camera calibration are validated.",
            "Risk map projection is demo-level approximate odom/map projection.",
        ],
    }


def draw_overlay(image_bgr: np.ndarray, detections: List[Dict[str, Any]], output_path: Path) -> None:
    import cv2

    out = image_bgr.copy()
    for det in detections:
        name = str(det.get("class_name") or det.get("label") or "risk")
        color = COLORS.get(name, (0, 255, 255))
        x, y, w, h = [int(round(float(v))) for v in det.get("bbox_xywh", [0, 0, 0, 0])]
        x2, y2 = x + w, y + h
        cv2.rectangle(out, (x, y), (x2, y2), color, 2)
        depth = det.get("depth_median_m")
        depth_text = "" if depth is None else f" {float(depth):.2f}m"
        text = f"{name} {float(det.get('confidence', 0.0)):.2f}{depth_text}"
        text_y = max(18, y - 6)
        cv2.rectangle(out, (x, text_y - 18), (x + min(430, 9 * len(text)), text_y + 4), color, -1)
        cv2.putText(out, text, (x + 3, text_y), cv2.FONT_HERSHEY_SIMPLEX, 0.5, (255, 255, 255), 1)
    output_path.parent.mkdir(parents=True, exist_ok=True)
    if not cv2.imwrite(str(output_path), out):
        raise RuntimeError(f"failed to write overlay image: {output_path}")


def risk_info_for_class(class_name: str) -> Tuple[str, str, str]:
    return CLASS_TO_EVENT.get(class_name, ("hard_obstacle", "medium", "stop_and_recheck"))


def parse_auto_risk_gates(spec: str) -> Dict[str, Dict[str, float]]:
    gates: Dict[str, Dict[str, float]] = {}
    if not str(spec or "").strip():
        return gates
    for item in str(spec).split(","):
        parts = [part.strip() for part in item.split(":")]
        if len(parts) != 4 or not parts[0]:
            raise ValueError(
                "auto risk gate entries must use class:min_conf:min_depth_m:max_depth_m, "
                f"got: {item!r}"
            )
        class_name = parts[0]
        min_confidence = float(parts[1])
        min_depth_m = float(parts[2])
        max_depth_m = float(parts[3])
        if min_depth_m > max_depth_m:
            raise ValueError(f"auto risk gate min depth > max depth for {class_name}")
        gates[class_name] = {
            "min_confidence": min_confidence,
            "min_depth_m": min_depth_m,
            "max_depth_m": max_depth_m,
        }
    return gates


def evaluate_auto_risk_gate(det: Dict[str, Any], gates: Dict[str, Dict[str, float]]) -> Dict[str, Any]:
    class_name = str(det.get("class_name") or det.get("label") or "risk")
    confidence = float(det.get("confidence") or 0.0)
    depth_value = det.get("depth_median_m")
    result: Dict[str, Any] = {
        "allowed": False,
        "class_name": class_name,
        "actual_confidence": round(confidence, 4),
        "actual_depth_m": depth_value,
    }
    gate = gates.get(class_name) or gates.get("*") or gates.get("all") or gates.get("any")
    if gate is None:
        result["reason"] = "class_not_enabled_for_auto_alarm_or_map"
        return result
    result.update(gate)
    if confidence < float(gate["min_confidence"]):
        result["reason"] = "confidence_below_gate"
        return result
    if depth_value is None:
        result["reason"] = "missing_depth"
        return result
    try:
        depth_m = float(depth_value)
    except (TypeError, ValueError):
        result["reason"] = "invalid_depth"
        return result
    result["actual_depth_m"] = round(depth_m, 4)
    if depth_m < float(gate["min_depth_m"]):
        result["reason"] = "depth_below_gate"
        return result
    if depth_m > float(gate["max_depth_m"]):
        result["reason"] = "depth_above_gate"
        return result
    result["allowed"] = True
    result["reason"] = "passed"
    return result


def build_ort_session_options(args: argparse.Namespace) -> Any:
    import onnxruntime as ort

    options = ort.SessionOptions()
    graph_levels = {
        "disabled": ort.GraphOptimizationLevel.ORT_DISABLE_ALL,
        "basic": ort.GraphOptimizationLevel.ORT_ENABLE_BASIC,
        "extended": ort.GraphOptimizationLevel.ORT_ENABLE_EXTENDED,
        "all": ort.GraphOptimizationLevel.ORT_ENABLE_ALL,
    }
    options.graph_optimization_level = graph_levels[str(args.ort_graph_optimization_level)]
    if int(args.ort_intra_op_threads) > 0:
        options.intra_op_num_threads = int(args.ort_intra_op_threads)
    if int(args.ort_inter_op_threads) > 0:
        options.inter_op_num_threads = int(args.ort_inter_op_threads)
    if args.ort_execution_mode == "sequential":
        options.execution_mode = ort.ExecutionMode.ORT_SEQUENTIAL
    elif args.ort_execution_mode == "parallel":
        options.execution_mode = ort.ExecutionMode.ORT_PARALLEL
    if args.ort_allow_spinning != "default":
        options.add_session_config_entry("session.intra_op.allow_spinning", str(args.ort_allow_spinning))
    return options


def odom_is_zero(odom: Optional[Dict[str, Any]], linear_eps: float, angular_eps: float) -> bool:
    if not odom:
        return False
    twist = odom.get("twist") or {}
    linear = twist.get("linear") or {}
    angular = twist.get("angular") or {}
    try:
        lx = abs(float(linear.get("x", 0.0)))
        ly = abs(float(linear.get("y", 0.0)))
        az = abs(float(angular.get("z", 0.0)))
    except (TypeError, ValueError):
        return False
    return lx <= linear_eps and ly <= linear_eps and az <= angular_eps
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
