RickSanchezC5163/spacemit-k1-edge-ai-risk-robot/(commit log)

2026-07-08 Prepare Spacemit K1 edge AI competition repository
    [robot_model.yaml]
2026-07-08 Clarify RRT MoveIt closed-loop flow
2026-07-08 Clarify RRT MoveIt closed-loop flow + Rl
2026-07-08 Clarify RRT MoveIt closed-loop flow + Rl +
2026-07-08 Clarify RRT MoveIt closed-loop flow + vertify +
2026-07-10 Add autonomous mapping simulation evidence
    [arm_5dof.xacro, chassis.xacro, common_inertials.xacro, empty_tracked_robot.sdf, gazebo_plugins.xacro, materials.xacro, ros2_controllers.yaml, sensors.xacro]
2026-07-11 Switch license to noncommercial use
2026-07-11 Import mechanical arm SW2URDF model
    [Link1.STL, Link2.STL, Link3.STL, Link4.STL, base_link.STL, mechanical_arm_1_visual.urdf, 机械臂1.csv, 机械臂1.urdf]
2026-07-11 Add mechanical arm RViz axes display
2026-07-11 Add debug visuals for mechanical arm
    [mechanical_arm_1_visual.urdf]
2026-07-11 Align mechanical arm base axis to Z up
    [mechanical_arm_1_visual.urdf]
2026-07-11 Disable mechanical arm collision geometry
    [mechanical_arm_1_visual.urdf]
2026-07-11 Show mechanical arm collision geometry in RViz
2026-07-11 Add simulated risk approach RRT loop
    [slam_rooms_risk_test.sdf]
2026-07-12 Add MoveIt TCP reach validation
    [joint_limits.yaml, mechanical_arm_1_visual.urdf]
2026-07-19 Tune real K1 full-chain mapping and risk visualization
2026-07-19 Document K1 full-chain mapping status
2026-07-19 Add K1 full-chain spatial risk validation
2026-07-21 Publish PI stop reset and semantic mapping tools
    [k1_calibrated_motion.py, wheeltec_tank_base_safe.py]
2026-07-23 Publish autonomous arm clearance workflow
    [discrete_arm_clearance.py, generate_moveit_gripper_sim_pick_place_plan.py, run_real_k1_discrete_arm_clearance.py]
2026-07-24 Publish autonomous lighting and reporting flow
