RickSanchezC5163/spacemit-k1-edge-ai-risk-robot/(notices)

Notices in the files:
README.md:
License: PolyForm Noncommercial 1.0.0
